TideGear/BoktaiSensor/README.md

I've done this all at my own expense.\
Please consider donating via...

 or 


https://ko-fi.com/TideGear

https://www.paypal.com/donate/?hosted_button_id=THMF458QTBCAL

----------------------------------------------------------------------

**Important!: This project is all very new, experimental, lightly-tested, and subject to change.\
I'm looking for serious contributors to...**

**1. Help tune the default device settings to *exactly* match how all three games handle a range of sunlight.** The defaults are roughly calibrated against real sunlight and a real Boktai 3 cartridge, but more testing across conditions and games is welcome. Where testing is ambiguous (e.g. flickering meter bar in the game), I tend to skew toward whatever is more "challenging" to achieve (seeking out more sunlight). The Ojo del Sol is meant to be the "no cheating" solution. However, keep in mind, I am talking about nit-picky, fractions of UVI.\
**2. Add support via Single Analog Control Mode to their emulators.**\
**3. Test and fix the code if needed.**\
**4. Create a cool 3D-printable case.**\
**5. You tell me!**

**...so please contact me if you are interested at TideGear @at@ gmail .dot. com !**

**Also contact me if you want to buy a pre-assembled device or kit!**

Photos of a build: https://photos.app.goo.gl/MvNCn2qLSqU6MgfA8 \
Made with this 1.7 x 1.7 x 0.79 inch case: https://a.co/d/01qMPdr9

----------------------------------------------------------------------

Ojo del Sol - ESP32-S3 UV Meter for Boktai Games
======================================================================

A substitute solar sensor for playing the Boktai series (Boktai 1, 2, 3)
on flash carts or emulators. Restores "Kojima's Intent" by using real
sunlight (UV) instead of artificial light hacks.

### Based on Prof9's Work

The GBA link cable ASM patches, IPS patches, and Ojo-del-Sol-side GBA link
protocol are based on [the gba-link-gpio branch of Prof9's Boktai Solar Sensor Patches](https://github.com/Prof9/Boktai-Solar-Sensor-Patches/tree/gba-link-gpio/Source).
Prof9's original code is released under the MIT License — see
[Prof9's license.txt](Prof9's%20license.txt) for details.

**Supported Games:**
- Boktai 1: The Sun Is in Your Hand (8-bar gauge)
- Boktai 2: Solar Boy Django (10-bar gauge)
- Boktai 3: Sabata's Counterattack (10-bar gauge)

----------------------------------------------------------------------

## Quick Start

**Recommended setup:** Incremental Mode (`HID_CONTROL_MODE = 0`) with mGBA libretro core (RetroArch), over either Bluetooth or USB XInput

1. Build the hardware (see [Hardware](#hardware) below)
2. Flash the firmware (see [Firmware Setup](#firmware-setup))
3. For mGBA libretro, set `HID_CONTROL_MODE = 0` in `config.h`
4. Pair the device as a Bluetooth controller in your OS
5. In mGBA (libretro), map **L3** to solar sensor decrease and **R3** to increase
6. Power on: hold button 2 seconds (T-QT Pro: the left button, next to USB; see [Button Controls](#button-controls))
7. Tap button to select game (BOKTAI 1, 2, or 3). (Optional) Tap to the **XInput** screen to view UV raw, UVI, compensated UVI, ADC avg, and battery voltage.
8. Point sensor toward the sky — the device syncs the in-game meter automatically
9. Hold button 2 seconds on a game screen to sleep. On the **XInput** screen, hold 2 seconds to enter CDC mode (USB serial / firmware upload).

**Important:** Only wake the device once you are in-game. The controller inputs it sends (button presses, stick deflections) may cause unwanted behavior in menus or other apps. When possible, put the device to sleep (hold 2s) when you are not actively playing a Boktai game.

**Important:** Placing the sensor behind standard glass or plastic blocks UV light. Use the `UV_ENCLOSURE_*` settings in `config.h` to compensate for your enclosure window. Strongly UV-blocking materials can still reduce usable range. The default transmittance (0.833) is currently a very quick and dirty calibration for these boxes: https://a.co/d/092sVvLT — adjust if you use a different enclosure.

----------------------------------------------------------------------

## Output Modes

The Ojo del Sol can output bar values in four ways. Choose based on your setup:

### 1. Bluetooth (Recommended for Emulators on PC or Mobile)
The device appears as an Xbox Series X controller ("Ojo del Sol Sensor") and sends button/stick inputs to control the emulator's solar sensor.

**Two HID control modes** (shared by Bluetooth and USB XInput; set via `HID_CONTROL_MODE` in config.h):

| Mode | How it works | Emulator support |
|---|---|---|
| **Incremental (default, mode 0)** | Sends L3/R3 button presses to step the meter up/down | **Works now** with mGBA libretro core |
| **Single Analog (mode 1)** | Better for Ojo del Sol! Maps bar count to proportional deflection on one analog axis | Requires emulator support |

**Current recommendation:** Use **Incremental Mode** with the **mGBA libretro core** in RetroArch until Single Analog Mode is supported by emulators (transport can be Bluetooth or USB XInput).

**Emulator developers:** See [For Emulator Devs.md](For%20Emulator%20Devs.md) for the Single Analog Mode specification, band mapping tables, and pseudocode.

### 2. USB XInput (Also Great for Emulators on PC or Mobile)
When `USB_HID_ENABLED = true`, normal boot enumerates as an Xbox 360-compatible USB XInput device (product string: `Ojo del Sol`) for emulator/game compatibility.
When `USB_HID_ENABLED = false`, the device automatically enters CDC mode on boot (one brief restart on first power-on or after a full power cycle; subsequent wakes return directly to CDC).
Both HID control modes are available over USB:
- **Incremental (`HID_CONTROL_MODE = 0`)**: sends `HID_BUTTON_DEC`/`HID_BUTTON_INC` step inputs and works independently of BLE state.
- **Single Analog (`HID_CONTROL_MODE = 1`)**: sends the configured axis plus optional unlock button (`HID_SINGLE_ANALOG_AXIS`, `HID_METER_UNLOCK_*`).

USB CDC serial is not active during normal XInput runtime. To enable USB serial (for `DEBUG_SERIAL` output or firmware upload):
1. Tap to the **XInput** screen (last screen in the cycle; this diagnostics screen is always present).
2. Hold the button for 2 seconds.
3. The device restarts into CDC mode and enumerates as `Ojo del Sol (CDC)`.

With `DEBUG_SERIAL = true`, CDC output includes startup diagnostics, device-button press events, and any enabled UV/battery debug streams.

In CDC mode the firmware runs fully (UV sensing, game display, screensaver, BLE, GBA link). The screen header shows **CDC** instead of **XInput**. Hold the button for 2 seconds from any screen to exit CDC mode and sleep; on next wake, the device boots back into XInput mode.

As an alternative, set `USB_HID_ENABLED = false` to have the firmware boot directly into CDC on wake.

### 3. GBA Link Cable (Best Option for Flash Carts)

This outputs a framed 3-wire value (SC + SD + SO) for use with a physical GBA via link cable. Supported on both boards (on the T-QT Pro it uses the board-edge solder pads IO16/IO17/IO18).

**Requirements:**
- Use the updated ROM hack IPS patches in this repo's `GBA Link Patches/` folder (`Source/` contains the ASM sources). Many thanks to Prof9 for the original proof-of-concept code!
- Recommended: install a real GBA link port on the Ojo del Sol and wire it as shown in [GBA Link Port Wiring.png](GBA%20Link%20Port%20Wiring.png). Link ports can be ordered here: https://a.co/d/00r3xzuj
- A breakout board also works, but the link cable can come loose easily if you move around much, so the real link port is the more robust option.
- Connect the Ojo del Sol to the **Player 1 (P1)** side of the cable and the GBA to the **Player 2 (P2)** side.

**Note:** The English translation of Boktai 3 should work with the patch, but this is currently untested.

**Limitation:** Boktai's normal link-cable modes (e.g., multiplayer) are **not compatible** with this and may never be. To use multiplayer alongside the Ojo del Sol, you'll need an emulator with link support (I've contacted Pizza Boy A Pro and Linkboy devs — TBD).

### 4. Display Only / Manual Entry (Not Recommended)
Read the bar count from the screen and enter it manually using Prof9's ROM hacks (https://github.com/Prof9/Boktai-Solar-Sensor-Patches). If you intend to use manual entry, **do not** use the ROM hacks in the GBA Link Patches directory. Those are for the GBA link cable method above.

**Note:** The screen is difficult to read in direct sunlight unless you shade it, so the display is really more for calibration and occasional reference.

----------------------------------------------------------------------

## Hardware

Two boards are supported. Select yours at the top of `config.h` (`BOARD_LILYGO_T_QT_PRO` is the default — see Option A below; uncomment `BOARD_SEEED_XIAO_ESP32S3` instead, and comment out the T-QT line, for the XIAO build in Option B).

### Option A: LilyGO T-QT Pro (minimal-wiring build, default)

The T-QT Pro build has been tested and works on real hardware. The GBA link solder pads are the least-exercised part, so please report any problems with them via a GitHub issue.

The [LilyGO T-QT Pro](https://github.com/Xinyuan-LilyGO/T-QT) has a built-in 0.85" 128x128 GC9107 color TFT, two buttons, battery charging, and battery voltage sensing — so the only wiring needed is the LTR390 and a battery.

**Components:**
- LilyGO T-QT Pro (ESP32-S3)
- Adafruit LTR390 UV Sensor (I2C) — connects to the T-QT's Qwiic connector; Adafruit's STEMMA QT version plugs straight in with a Qwiic/STEMMA QT cable, no soldering
- 3.7V LiPo battery (solder to the battery pads or use the connector, depending on your unit)

**T-QT Pro notes:**
- If you wire to the Qwiic connector manually instead of using a cable: SDA = GPIO43, SCL = GPIO44. (Beware: the pinout image and board silkscreen swap the Qwiic SDA/SCL labels; SDA = GPIO43, SCL = GPIO44 matches the schematic and actually works — [details](https://github.com/Xinyuan-LilyGO/T-QT/issues/17).)
- **Solder-pad sensor option:** set `I2C_SDA_PIN = 33` and `I2C_SCL_PIN = 34` in `config.h` to wire the sensor to the IO33/IO34 pads instead, freeing the Qwiic connector. I2C then needs pull-ups on SDA/SCL; the Adafruit LTR390 breakout includes 10K pull-ups on board, so no extra parts are needed with it.
- GBA link output is supported via the board-edge solder pads: IO16 (SC), IO17 (SD), IO18 (SO), plus the adjacent GND pad. See [GBA Link Cable Wiring](#gba-link-cable-wiring-optional).
- **Cartridge sensor option (untested):** a real Boktai cartridge can be wired up in place of the LTR390. See [Cartridge Sensor](#cartridge-sensor-t-qt-pro-optional--untested).
- Battery sensing is built in (2:1 divider on GPIO4) and enabled by default; no resistors needed.
- **Right button (GPIO47)** advances to the next screen (BOKTAI 1 → 2 → 3 → XInput). **Left button (GPIO0)** is the power button (hold 2s) — it is the only button that can wake the board from deep sleep — and a tap on it cycles screens backward.
- The UI renders as a 128x64 region centered on the square screen (top/bottom letterboxed). Set `TQT_DISPLAY_ROTATION` in `config.h` if your case orientation needs the screen flipped.

### Option B: Seeed XIAO ESP32S3 (original build)

**Components:**
- Seeed XIAO ESP32S3 (built-in LiPo charging)
- Adafruit LTR390 UV Sensor (I2C)
- SSD1306 128x64 OLED Display (I2C)
- Tactile push button (power/game select)
- 3.7V LiPo battery (300mAh works well; larger capacity is optional but be mindful of your case size)
- 2x 100K ohm resistors (for battery monitoring — optional but recommended)

### Wiring

*(XIAO ESP32S3 build only — the T-QT Pro just needs the LTR390 on the Qwiic connector (or the IO33/IO34 pads, see above) or a [cartridge](#cartridge-sensor-t-qt-pro-optional--untested), a battery, and the GBA link pads below if you use that output.)*

| Component | Pin | XIAO ESP32S3 | Notes |
|---|-----|---|---|
| OLED VIN | | 3V3 | 3.3V power |
| OLED GND | | GND | |
| LTR390 VIN | | 3V3 | 3.3V power |
| LTR390 GND | | GND | |
| OLED + LTR390 SDA | | D4 (GPIO5) | I2C data (configurable via `I2C_SDA_PIN`) |
| OLED + LTR390 SCL | | D5 (GPIO6) | I2C clock (configurable via `I2C_SCL_PIN`) |
| Button | Leg A | D0 (GPIO1) | Signal (internal pull-up) |
| Button | Leg B | GND | |
| Battery + | | BAT+ (back pad) | Farthest from USB-C |
| Battery - | | BAT- (back pad) | Closest to USB-C |

### Battery Monitoring (Optional)

The XIAO doesn't expose battery voltage directly. To enable battery percentage display, add a voltage divider:

```
BAT+ ----[100K]----+---- D1 (GPIO2)
                   |
                 [100K]
                   |
GND ---------------+
```

Battery sensing is disabled by default (`BATTERY_SENSE_ENABLED = false`). After wiring the divider, set `BATTERY_SENSE_ENABLED = true` in `config.h` to show battery data.

**Calibration:** If battery % is wrong at full charge, adjust `VOLT_DIVIDER_MULT` in config.h (increase if reading low, decrease if high).

### GBA Link Cable Wiring (Optional)

Only needed if using GBA Link output mode. Recommended: install a real GBA link port on the Ojo del Sol and wire it as shown in [GBA Link Port Wiring.png](GBA%20Link%20Port%20Wiring.png). Link ports can be ordered here: https://a.co/d/00r3xzuj

A breakout board such as the [Palmr breakout board](https://github.com/Palmr/gb-link-cable) still works, but the link cable can come loose easily if you intend to move around much. An actual link port is a much more robust solution.

**Recommended Ojo-side link port wiring (XIAO ESP32S3):**

| Ojo Connection | Ojo-side GBA Port Pin Type | Equivalent P1 Breakout Pad | Notes |
|---|---|---|---|
| D9 (GPIO8) | SI | SO | Payload bit 0 |
| GND | GND | SI | Shared ground |
| D8 (GPIO7) | SD | SD | Payload bit 1 |
| D7 (GPIO44) | SC | SC | Frame phase; toggles every `GBA_LINK_FRAME_TOGGLE_MS` |

**Recommended Ojo-side link port wiring (T-QT Pro):** same as above, using the board-edge solder pads next to the GND pad:

| Ojo Connection | Ojo-side GBA Port Pin Type | Equivalent P1 Breakout Pad | Notes |
|---|---|---|---|
| IO18 pad | SI | SO | Payload bit 0 |
| GND pad | GND | SI | Shared ground |
| IO17 pad | SD | SD | Payload bit 1 |
| IO16 pad | SC | SC | Frame phase; toggles every `GBA_LINK_FRAME_TOGGLE_MS` |

Leave the Ojo-side port `SO` and `VDD35` contacts unconnected. If you use a breakout board instead of a port, wire the equivalent P1 breakout pads listed above.

**Cheap cable continuity and cable orientation:**

Cheap GBA link cables have non-standard internal wiring (no mid-cable signal splitter), and the two ends are not equivalent. Plug the Ojo del Sol into the **Player 1 (P1)** side of the cable and the GBA into the **Player 2 (P2)** side.

Verify your specific cable's wiring with a multimeter continuity test. See [this sheet](https://docs.google.com/spreadsheets/d/19uAjLaDji9D3lIKIEdB9RHNQ_F-Fo1NnXY90uRH3dQA/edit?usp=sharing) for reference.

Expected continuity on this cheap-cable variant:
- P1 Pin 2 -> P2 Pin 3
- P1 Pin 3 -> P2 Pin 6
- P1 Pin 4 -> P2 Pin 4
- P1 Pin 5 -> P2 Pin 5

This wiring intentionally uses the conductor that routes P1 Pin 3 to P2 Pin 6 as the shared ground path between the Ojo and GBA.

**Important - shield and "GND" labels:**

- Shell/shield continuity is often missing on cheap cables, so do not assume shield gives ground reference.
- On this wiring method, shared ground comes from the P1 Pin 3 conductor routed to P2 Pin 6.

**`GBA_LINK_FRAME_TOGGLE_MS` explained:**

- This value is the hold time for one frame phase (`SC` low or high).
- One full 4-bit bar value needs two phases, so ideal full refresh time is roughly `2 * GBA_LINK_FRAME_TOGGLE_MS`.
- Firmware schedules phase timing with a microsecond clock, so `GBA_LINK_FRAME_TOGGLE_MS` is now honored much more closely than simple loop-delay timing.
- Example: `5ms` targets about `10ms` per full value (~100 full updates/sec), subject to normal loop jitter.
- Lower values respond faster but reduce electrical timing margin; higher values are slower but more tolerant.

**Notes:**
- Keep all signals at 3.3V logic (both supported boards are 3.3V native, so no level shifting is needed)
- The ESP32 writes data pins (SD, SO) before the phase pin (SC) so the GBA always samples stable data when it detects a phase edge. The GBA-side ASM patches include a consecutive-match check that discards any single-frame misread, adding one frame (~17ms) of latency on real bar changes but eliminating visible glitches.

### Cartridge Sensor (T-QT Pro, Optional) — UNTESTED

> **Status: untested.** This option compiles, but it has never been run with a cartridge attached. It uses the same reading method as the [Ojo del Sol Calibrator](OjoDelSolCalibrator/README.md), whose cartridge reading has not been run on hardware yet either. Expect to debug it, and please report results (working or not) via a GitHub issue.

Instead of the LTR390, the T-QT Pro build can read a **real Boktai cartridge's own solar sensor** over the GBA cartridge bus. It turns that reading into bars with the games' own level formula and bar tables. Two things keep it from being an exact copy of the game:
- **It needs a calibration number.** This is a dark baseline, `CART_CALIBRATION` (see below), and the default of 230 is a guess.
- **It reads every game with the Boktai 2/3 sequence.** Boktai 1's sequence differs slightly and may give a raw value one count higher. That should cancel out, because the calibration and the readings both come from the same sequence, but it is untested ([details](OjoDelSolCalibrator/README.md#not-verified-yet)).

It uses one sensor or the other, never both; to log a cartridge and an LTR390 side by side, use the calibrator.

To enable it, comment out `#define SENSOR_LTR390` and uncomment `#define SENSOR_GBA_CARTRIDGE` near the top of `config.h`. The XIAO build does not support it.

**Wiring (T-QT Pro):** the cartridge runs at 3.3 V, so no level shifting is needed. Cartridge pin numbers match [`References/gba_cartridge_pinout.svg`](References/gba_cartridge_pinout.svg).

"Cart VCC" below is the cartridge's switched supply from the power switch (next paragraph), or plain 3V3 if you leave the switch out.

| Cartridge pin(s) | Connect to |
|---|---|
| VCC (1) | Cart VCC |
| GND (32) | GND (the Qwiic connector's GND pin works) |
| /WR (3), /RD (4), /CS (5) | IO33, IO34, IO35 pads, each with a ~10 k pull-up to Cart VCC (recommended: the firmware floats these during deep sleep and boot, and the pull-ups keep the cartridge idle) |
| AD0–AD3 (6–9) | IO36, IO37, IO38, IO39 pads |
| AD5 (11), AD6 (12) | GPIO43, GPIO44 (the Qwiic connector's SDA and SCL; the LTR390 isn't used, so the connector is free) |
| AD4 (10) and AD7–AD15 (13–21) | each through ~10 k to GND |
| A16–A23 (22–29) | GND |
| /CS2 (30) | Cart VCC, wired directly |
| CLK (2), /IRQ (31) | leave unconnected |

**Cartridge power switch (recommended):** without it, the cartridge stays powered from 3V3 while the Ojo del Sol is asleep, and that sleep current is unmeasured. Use a logic-level P-channel MOSFET such as an AO3401A or Si2301. Connect its source to 3V3 and its drain to Cart VCC. Connect its gate to the IO48 pad, with a ~100 k resistor from the gate to 3V3. The firmware drives IO48 low to switch the cartridge on once the device has been powered on, and high again before sleeping or restarting. During deep sleep IO48 floats and the resistor keeps the switch off. Tie the pull-ups and /CS2 to Cart VCC, not 3V3, so they don't feed an unpowered cartridge. If you leave the switch out, wire Cart VCC straight to 3V3; the firmware's IO48 output then does nothing (or set `CART_POWER_PIN = -1`).

The tie-offs are the same as the calibrator's; its README explains [why each one is needed](OjoDelSolCalibrator/README.md#hardware). The pins can be changed in the `CARTRIDGE SENSOR` section of `config.h`. The GBA link pads (IO16–IO18) are still free, so the link output works alongside the cartridge; every other pad is in use. Power the board off before inserting or removing the cartridge.

**Setting it up:**
- **Calibration:** the game turns the cartridge's raw value into a 0–140 level with `level = calibration − raw`. It stores a reading taken during its sensor setup, minus 2, as its calibration; that part is confirmed from the ROM. It is not confirmed that the reading is meant to be taken in the dark, but that is the working assumption (the [calibrator README](OjoDelSolCalibrator/README.md#reading-the-data) makes the same one). So: cover the sensor, switch to the XInput/CDC screen, read **Raw**, and set `CART_CALIBRATION` to that value minus 2. The default of 230 is only a starting guess.
- **Boktai 1 (E):** set `CART_BOKTAI1_EUROPE_TABLE = true` so the BOKTAI 1 screen uses the European release's bar table (see [Automatic Mode](#automatic-mode-default)).
- The UV settings in [Calibration](#calibration) (`AUTO_UV_*`, enclosure compensation, smoothing, hysteresis) are not used.

**What changes:**
- The game screens show the cartridge's **Level** (0–140) instead of the UV index. They show **No cart** when the sensor never answered (no cartridge, or a wiring fault), and the meter then reads 0 bars.
- The XInput/CDC screen shows:
  - **Raw** and **Lvl:** the latest raw value and the level in use.
  - **Bus:** the read-back check (`ok` or `FAIL`, a rough wiring check) and how long the reading took.
  - **Late** and **Rej:** the latest reading's most delayed tick, and how many readings were discarded as late (see below).
- A reading starts every `CART_READ_INTERVAL_MS` (500 ms) and takes up to about 0.4 s, longest in the dark. Each sensor tick runs from a hardware timer interrupt, so the buttons, display and HID output keep running during a reading.
- **Protection against timing disturbance:** the timer interrupt runs on core 1, so the Bluetooth stack and controller (core 0) can't delay it. Flash writes, such as saving a Bluetooth pairing, still pause it briefly. Any reading with a tick more than `CART_TICK_MAX_LATE_US` (250 µs) late is discarded, and the previous level is kept. Set it to 0 to keep every reading.

**Not verified yet:**
- Everything on the calibrator's [not verified](OjoDelSolCalibrator/README.md#not-verified-yet) list about the bus timing, the tied-off lines and Boktai 1 cartridges.
- How sensitive the sensor is to tick timing at all, and so whether 250 µs is the right limit. Watch **Late** and **Rej** while Bluetooth is pairing and connected.
- The power switch: whether switching on the cartridge dips the 3V3 rail enough to reset the board, and the actual current draw, awake and asleep. GPIO43 is the boot ROM's serial output and sits high for a moment at power-up before the firmware floats it. While the cartridge is switched off, that can feed a little current into its AD5 pin.

----------------------------------------------------------------------

## Firmware Setup

### Libraries Required

**Install via Arduino Library Manager:**
- Adafruit LTR390 Library (not needed with the cartridge sensor)
- Adafruit SSD1306 (XIAO build only)
- Adafruit GFX Library
- Adafruit BusIO
- NimBLE-Arduino (by h2zero)
- Callback (by Tom Stewart)
- GFX Library for Arduino (by moononournation, a.k.a. Arduino_GFX) — **T-QT Pro build only**; no configuration needed, the display pins are fixed board wiring set in `TQTDisplay.h`

**Install manually (included in repo as ESP32-BLE-CompositeHID-master.zip, or download from GitHub):**
- ESP32-BLE-CompositeHID: https://github.com/Mystfit/ESP32-BLE-CompositeHID

**Why not TFT_eSPI (which LilyGO's own T-QT samples use)?** TFT_eSPI's last release (2.5.43) crashes in `tft.init()` on the ESP32-S3 under esp32 core 3.x (StoreProhibited panic → boot loop; [known issue](https://github.com/Bodmer/TFT_eSPI/issues/3329)). LilyGO's samples work because they bundle a modified TFT_eSPI and target the older 2.0.x core, but this project requires core 3.x. Arduino_GFX supports the GC9107 natively on current cores.

### Board Settings (Arduino IDE)

- **Boards Manager URL:** `https://raw.githubusercontent.com/espressif/arduino-esp32/gh-pages/package_esp32_index.json`
- **Board package:** esp32 by Espressif Systems, version 3.x
- **Board:**
  - XIAO build: **XIAO_ESP32S3**
  - T-QT Pro build: **ESP32S3 Dev Module** (no T-QT entry exists in the ESP32 core) with these settings — everything not listed stays at its default:
    - **Flash Size:** 4MB (32Mb) for the common N4R2 variant; 8MB (64Mb) for the N8 variant (chip marking `ESP32-S3FN4R2` = N4R2)
    - **PSRAM:** QSPI PSRAM (N4R2) or Disabled (N8)
    - **Partition Scheme:** Huge APP (3MB No OTA/1MB SPIFFS) — the sketch is too large for the default 1.2MB app partition
    - **Flash Mode:** QIO 80MHz, **CPU Frequency:** 240MHz, **Events/Arduino Run On:** Core 1 (the cartridge sensor's tick timer relies on this to stay off the Bluetooth core)
    - USB settings identical to the XIAO build (below)
- **USB Mode:** USB-OTG (TinyUSB)
- **USB CDC On Boot:** Enabled (required for CDC mode; normal runtime remains XInput unless you enter CDC mode from the XInput screen or set `USB_HID_ENABLED = false`)
- **Upload Mode:** USB-OTG CDC (TinyUSB) (required for CDC-mode uploads; UART0/Hardware CDC will fail to auto-connect in this setup)
- If CDC UI appears inconsistent/garbled after failed uploads, do one upload with **Erase All Flash Before Sketch Upload = Enabled**, then set it back to Disabled.
- Remember to select your board at the top of `config.h` as well (`BOARD_SEEED_XIAO_ESP32S3` or `BOARD_LILYGO_T_QT_PRO`), and the sensor just below it (`SENSOR_LTR390`, the default, or `SENSOR_GBA_CARTRIDGE`).

----------------------------------------------------------------------

## Usage

### Button Controls

**When device is ON:**
- **Tap:** Cycle screens (BOKTAI 1 → 2 → 3 → XInput → 1...). The XInput screen is always present and doubles as the diagnostics screen.
- **Hold 2s on a game screen:** Power OFF (deep sleep)
- **Hold 2s on the XInput screen:** Restart into CDC mode for USB serial output and firmware upload
- **Hold 2s while in CDC mode:** Exit CDC mode and sleep (next wake returns to XInput mode)
- If screensaver is active, first tap wakes the screen

**When waking from sleep:**
- **Hold 2s:** Power ON
- **Short press/tap:** Immediately shows "Hold 2s to power on"
- If there is no button activity for 10 seconds, it returns to sleep

**T-QT Pro:** The **right button** advances to the next screen when the device is on; it has no long-press action and cannot wake the device from sleep (hardware limitation — only GPIO0 is wake-capable). The **left button (GPIO0)** handles everything else described above (hold 2s for power/CDC), except its tap cycles screens *backward* instead of forward. Directions are configurable via `BUTTON_TAP_STEP`/`BUTTON2_TAP_STEP` in config.h.

### HID Control Mode Details (Bluetooth + USB)

**Incremental Mode specifics:**
- Works over both Bluetooth and USB XInput.
- The firmware tracks the in-game meter state and sends L3/R3 presses to sync it
- On BLE connections, performs a clamp+refill resync every `BLE_RESYNC_INTERVAL_MS` (default 60s)
- Press rate controlled by `HID_BUTTONS_PER_SECOND` (default 20)
- For Boktai 1, mGBA uses 10 internal steps despite 8 visible bars — the firmware compensates (disable via `HID_BOKTAI1_MGBA_10_STEP_WORKAROUND = false` if fixed)
- **Button remapping:** Change `HID_BUTTON_DEC` and `HID_BUTTON_INC` in config.h to use different buttons (see `XboxGamepadDevice.h` for available constants)

**Single Analog Mode specifics:**
- Works over both Bluetooth and USB XInput.
- Updates immediately on bar change (no rate throttling)
- Maps bar count to a proportional deflection on a configurable analog axis (default: Right X+)
- Optionally holds a configurable "meter unlock" button (default: R3) while the axis is active (`HID_METER_UNLOCK_BUTTON_ENABLED`). Single Analog mode uses midpoint band mapping, so even 0 bars sends a small deflection (not exact center).
- Bluetooth path: the unlock button is released/re-pressed on each deflection change and periodically (`HID_METER_UNLOCK_REFRESH_MS`, default 1000ms) so apps/emulators that start listening late can still register it as held.
- USB path: the unlock button is held while active and updated with normal USB reports (no periodic release/re-press refresh cycle).
- Axis and unlock button are configurable in config.h (`HID_SINGLE_ANALOG_AXIS`, `HID_METER_UNLOCK_BUTTON`)

### Bluetooth-Specific Details

The device advertises as "Ojo del Sol Sensor" (configurable via `BLE_DEVICE_NAME`).

**Pairing/connection behavior:**
- Times out after `BLE_PAIRING_TIMEOUT_MS` (default 60s)
- Re-enters pairing if connection drops
- **Pairing restarts on wake** — after waking from sleep, the device re-advertises for pairing
- Bluetooth icon flashes while pairing, solid when connected

### Screensaver

After `SCREENSAVER_TIME` minutes (default 3) of no button activity, the display shows a bouncing "Ojo del Sol" logo. Press any button to wake. Set `SCREENSAVER_TIME = 0` to disable (but this affects OLED lifespan). Alternatively, set `SCREENSAVER_ACTIVE = false` to disable it without changing the time value. The status row appears only when battery data is available and/or BLE is actively connected or pairing.

On the T-QT Pro the screensaver is disabled by default (`SCREENSAVER_ACTIVE = false` in its branch of `config.h`): its LCD isn't prone to OLED-style burn-in, and the screensaver leaves the backlight on, so it would save no power. Set it to `true` if you want it anyway.

----------------------------------------------------------------------

## Calibration

*(LTR390 builds. With the [cartridge sensor](#cartridge-sensor-t-qt-pro-optional--untested), only `CART_CALIBRATION` applies.)*

### Automatic Mode (Default)

Bar thresholds are calculated from two values in config.h:

```c
const bool AUTO_MODE = true;
const float AUTO_UV_MIN = 1.000;   // UV Index for 1 bar
const float AUTO_UV_SATURATION = 13.100;   // UV Index ceiling (output clamp)
```

Bars are distributed non-linearly following the original Boktai cartridge's thresholds (per [Raphi's sensor graph](https://raphi.xyz/~raphi/boktai/sensor_graph/)), scaled across the configured UV range. `AUTO_UV_MIN` is where bar 1 starts; `AUTO_UV_SATURATION` is where the highest bar starts (and all values above are clamped to max).

**Original cartridge bar thresholds** (0–140 scale; source: [raphi.xyz/~raphi/boktai/sensor_graph/](https://raphi.xyz/~raphi/boktai/sensor_graph/)):

```
Exclusive upper bound
Bars    Boktai 1    Boktai 2 & 3
0       1           1
1       7           6
2       16          13
3       28          23
4       44          35
5       67          50
6       98          67
7       140         87
8       (max)       110
9       —           140
10      —           (max)
```

The Boktai 1 column above matches the Japanese and US releases. **Boktai 1 (E)** (Europe) uses different thresholds, found by disassembling the ROM's bar-ladder routine (the first value at which each bar starts, in the same 0–140 scale):

```
Bars    Boktai 1 (E)
1       1
2       7
3       15
4       25
5       38
6       56
7       98
8       140
```

This differs from Raphi's Boktai 1 table (bars 3–6 start at 16, 28, 44 and 67 there). The config.h thresholds follow Raphi's table, so they do not reproduce the European release's gauge exactly.

`AUTO_UV_MIN` maps to scaled value 1 and `AUTO_UV_SATURATION` maps to 140.

### Manual Mode

Set `AUTO_MODE = false` to use per-game `BOKTAI_1/2/3_UV_MIN` and `BOKTAI_1/2/3_UV_SATURATION` values (`BOKTAI_1_UV_MIN`, `BOKTAI_1_UV_SATURATION`, etc.). Bar thresholds follow the same non-linear cartridge curve as AUTO mode, but each game can use a different UV range.

### Transparent Enclosure Compensation

If the sensor is behind a transparent window, model that window as transmission loss:

```c
const bool UV_ENCLOSURE_COMP_ENABLED = true;
const float UV_ENCLOSURE_TRANSMITTANCE = 0.42; // 42% UV passes through the window
const float UV_ENCLOSURE_UVI_OFFSET = 0.000;     // Optional bias correction
```

The current repo default in `config.h` is `0.833`, based on the enclosure linked above; expect to recalibrate this value for your own case/window material.

Firmware applies compensation once after raw-to-UVI conversion:

`corrected_uvi = max(0, (measured_uvi - offset) / transmittance)`

Quick calibration:
1. Temporarily set `UV_ENCLOSURE_COMP_ENABLED = false` while collecting calibration readings.
2. Take side-by-side readings at the same time/angle: one sensor open-air, one in-box.
3. Compute `in_box_uvi / open_air_uvi` across several samples.
4. Use the median ratio as `UV_ENCLOSURE_TRANSMITTANCE`.
5. Re-enable compensation (`UV_ENCLOSURE_COMP_ENABLED = true`).

**Threshold calibration mode:** By default (`UV_THRESHOLDS_CALIBRATED_OPEN_AIR = true`), all threshold values in config.h (`AUTO_UV_MIN`, `AUTO_UV_SATURATION`, and the per-game `BOKTAI_*_UV_MIN`/`BOKTAI_*_UV_SATURATION` values) are assumed to be open-air UVI values — set while the case is open or without an enclosure. The firmware compensates sensor readings to open-air equivalent before comparing against them. Set `UV_THRESHOLDS_CALIBRATED_OPEN_AIR = false` if you instead calibrated thresholds with the sensor inside the closed enclosure; bar comparison will then use the raw (uncompensated) reading directly.

For open-air builds (sensor always exposed when device is in use): set `UV_ENCLOSURE_COMP_ENABLED = false` and leave `UV_THRESHOLDS_CALIBRATED_OPEN_AIR = true`. Compensation is a no-op so raw equals compensated.

Note: On the XInput screen, `UVI` is the measured (pre-compensation) value and `UVI comp'ed` is the value used for bar calculation (post-compensation; post-smoothing if `UVI_SMOOTHING_ENABLED = true`).

### Stability Tuning

If the bar display feels jumpy:
- `UVI_SMOOTHING_ENABLED`: Applies exponential smoothing (default: `false`; set `true` to smooth)
- `UVI_SMOOTHING_ALPHA`: Controls how much weight new readings get vs. the running average (default: `0.5`; higher = faster response, lower = smoother). Setting `UVI_SMOOTHING_ALPHA = 1.0` is the same as `UVI_SMOOTHING_ENABLED = false`.
- `BAR_HYSTERESIS_ENABLED`: Enables bar hysteresis (default: `false`). Setting `BAR_HYSTERESIS_ENABLED = false` is the same as `BAR_HYSTERESIS = 0.0`.
- `BAR_HYSTERESIS`: Requires UV margin before changing bars (default: `0.200`; only used when `BAR_HYSTERESIS_ENABLED = true`)

----------------------------------------------------------------------

## Ojo del Sol Calibrator — PARTLY TESTED

A separate device (partly tested: the Wi-Fi, web app, logging and LTR390 work on the board; the cartridge side has not been tried yet) in [`OjoDelSolCalibrator/`](OjoDelSolCalibrator/) that reads a real Boktai cartridge's solar sensor and an LTR390 at the same moment and logs both, to tune `AUTO_UV_MIN`, `AUTO_UV_SATURATION` and the bar thresholds against the real hardware. See the [calibrator README](OjoDelSolCalibrator/README.md) for its hardware, wiring, firmware setup and Wi-Fi web app.

----------------------------------------------------------------------

## Technical Notes

### Original Boktai Cartridge Sensor (from GBATEK and Drakodan)
- **Chip**: Hamamatsu Photonics G5842 (UV photodiode with 8-bit ADC)
- **Spectral range**: 260–400nm, centered at ~370nm (UV-A dominant)
- Values **inverted**: 0xE8 = darkness, 0x50 = max gauge, 0x00 = extreme
- Accessed via GPIO at 0x80000C4-0x80000C8

### LTR390 UV Sensor
- Reference sensitivity: 2300 counts/UVI at 18x gain, 400ms integration
- Formula (measured): `UVI = raw / 2300` (at our settings: gain 18x, 20-bit/400ms, 500ms rate)
- Formula (corrected, optional enclosure compensation): `UVI = max(0, (measured_uvi - offset) / transmittance)`
- Peak response: 300-350nm (UV-A/UV-B)
- **Not inverted**: higher values = more UV

### Power Management
- Wire the LTR390 directly to `3V3`, same as the OLED
- Cutting the LTR390 breakout LED trace is recommended because the LED is hardwired to VIN
- Battery sensing is enabled by default on the T-QT Pro (built-in divider) and disabled by default on the XIAO build; low-voltage cutoff is disabled by default on both. Enable them after wiring (XIAO) and validating the battery divider (`BATTERY_SENSE_ENABLED`, `BATTERY_CUTOFF_ENABLED`)
- Battery sampling/cutoff checks run on a timed loop and are not dependent on UV "new data" events
- XIAO build: the OLED uses Display OFF + Charge Pump OFF commands, and on wake the firmware explicitly re-enables the charge pump/display before drawing
- T-QT Pro: the panel is put to sleep and the backlight cut; the backlight pin is held off through deep sleep
- Deep sleep current: not measured on either board

### UV Blocking Warning
Most glass and many plastics block UV strongly (often 90%+). Compensation can correct scale loss, but it cannot recover signal if too little UV reaches the sensor. Prefer an open aperture, quartz glass, or UV-transparent acrylic.

----------------------------------------------------------------------

## Troubleshooting

### UV sensor reads 0 or very low
If button presses are being seen, Serial should print `Device button pressed` whenever the device button is pressed.
1. Set `DEBUG_SERIAL = true` and check Serial Monitor (115200 baud). Serial output is only active in CDC mode — enter CDC mode from the XInput screen (hold 2s), or set `USB_HID_ENABLED = false` to always use CDC.
   - At UVI 6, expect ~13800 raw counts (6 × 2300)
   - If raw = 0, sensor may not be in UV mode
2. Ensure sensor faces the sky (not blocked by hand/case)
3. If using an enclosure window, verify `UV_ENCLOSURE_TRANSMITTANCE` and use UV-transparent material
4. Indoor UV is near zero — test outside

### Battery shows 0%
XIAO build: you need the voltage divider circuit and `BATTERY_SENSE_ENABLED = true`. Keep battery sensing disabled until the divider is wired. (The T-QT Pro's divider is built in, so this doesn't apply there.)

### Battery % is wrong
Adjust `VOLT_DIVIDER_MULT` in config.h (increase if reading low, decrease if high).

### Device powers off quickly
Check `BATTERY_CUTOFF_ENABLED` and `VOLT_CUTOFF`. Cutoff is disabled by default; only enable it after battery sensing is wired and validated.

### Device won't wake
1. Hold button for full 2 seconds
2. A short press should immediately show the "Hold 2s to power on" prompt
3. After 10s of no activity, it returns to sleep
4. If the display fails to initialize, the device enters deep sleep after about 2 seconds using the normal sleep path (same cleanup and button-release debounce as manual sleep). On the XIAO build, check I2C wiring and `DISPLAY_I2C_ADDR` in config.h (some modules use `0x3D` instead of `0x3C`)
5. T-QT Pro: only the **left button (GPIO0, next to USB)** can wake the device — the right button does nothing while asleep

### Display is blank, mirrored, or inverted after entering CDC mode
1. Update to the latest firmware (the boot sequence now re-asserts OLED power and canonical panel state after the software restart)
2. Confirm `Tools > Upload Mode` is set to `USB-OTG CDC (TinyUSB)`
3. If needed, re-enter CDC mode once (hold 2s on the XInput screen), then upload again

### BLE crashes at startup (`block_locate_free` TLSF assert)
This was a known compatibility issue between esp32 core `3.3.7` and older versions of NimBLE-Arduino. It is resolved as of NimBLE-Arduino v2.3.9 — update the library via Arduino Library Manager and rebuild.

### T-QT Pro: build fails with `Arduino_GFX_Library.h: No such file or directory`
Install "GFX Library for Arduino" (by moononournation) via the Library Manager.

### T-QT Pro: boot loop / COM port keeps disconnecting and reconnecting
If you modified the code to use TFT_eSPI: its last release (2.5.43) crashes at `tft.init()` on ESP32-S3 with esp32 core 3.x — this firmware uses Arduino_GFX instead for exactly that reason. Otherwise, set `USB_HID_ENABLED = false` temporarily and watch the serial monitor: the firmware prints a boot banner and a marker after each init stage, so the last line tells you which step crashes.

### T-QT Pro: screen shows garbage, wrong colors, or an offset image
T-QT units exist with two panel revisions (LilyGO ships separate factory firmware for the newer panel). Arduino_GFX's GC9107 driver works on the unit this project was tested with, but only one revision has been tried; if your unit misbehaves, try `TQT_DISPLAY_ROTATION` values 0-3 in config.h first, then report it via a GitHub issue — the panel-specific init from LilyGO's [`extras` folder](https://github.com/Xinyuan-LilyGO/T-QT/tree/main/extras) may need porting.

----------------------------------------------------------------------

## Future Plans

- [ ] Lunar Knights support?

----------------------------------------------------------------------

## Credits & Links

- **[Prof9](https://github.com/Prof9/Boktai-Solar-Sensor-Patches)** — GBA link patches, IPS patches, and link protocol are based on Prof9's work (MIT License — see [Prof9's license.txt](Prof9's%20license.txt)) Prof9 also provided a ridiculous amount of help, patience, and kindness. Many thanks!
- **[Raphi](https://raphi.xyz/~raphi/boktai/sensor_graph/)** — Original Boktai cartridge bar threshold tables, reverse-engineered from the original hardware. This saved me a lot of work!
- **[Mystfit](https://github.com/Mystfit/ESP32-BLE-CompositeHID)** — ESP32-BLE-CompositeHID library (included as `ESP32-BLE-CompositeHID-master.zip`)
- **[Kalasoiro](https://github.com/Kalasoiro/esp32s3-tinyusb-xinput)** - XInput TinyUSB reference implementation (included as `esp32s3-tinyusb-xinput-main.zip`)
- **LanHikariDS** — Additional support via Discord
- **[Drakodan](https://tasvideos.org/9369S)** — Original cartridge sensor chip identification (Hamamatsu Photonics G5842) and spectral range documentation
- [GBATEK Solar Sensor Documentation](https://problemkaputt.de/gbatek.htm)
- [Seeed XIAO ESP32S3 Wiki](https://wiki.seeedstudio.com/xiao_esp32s3_getting_started/)
- [Adafruit LTR390](https://www.adafruit.com/product/4831)

----------------------------------------------------------------------

## Legal Disclaimer

This project is for hobbyist and entertainment use only and does not provide medical advice. Consult a physician or other qualified healthcare professional for guidance on safe and appropriate sunlight exposure for your situation.

Do not rely on video games or the Ojo del Sol as an indicator of how much sunlight or UV exposure you should get. They are gameplay devices, not health or safety instruments.

This project is an independent fan-made hardware/firmware project and is not affiliated with, endorsed by, or sponsored by Konami or Hideo Kojima.
