TideGear/BoktaiSensor/References/UV Sensor.jpg

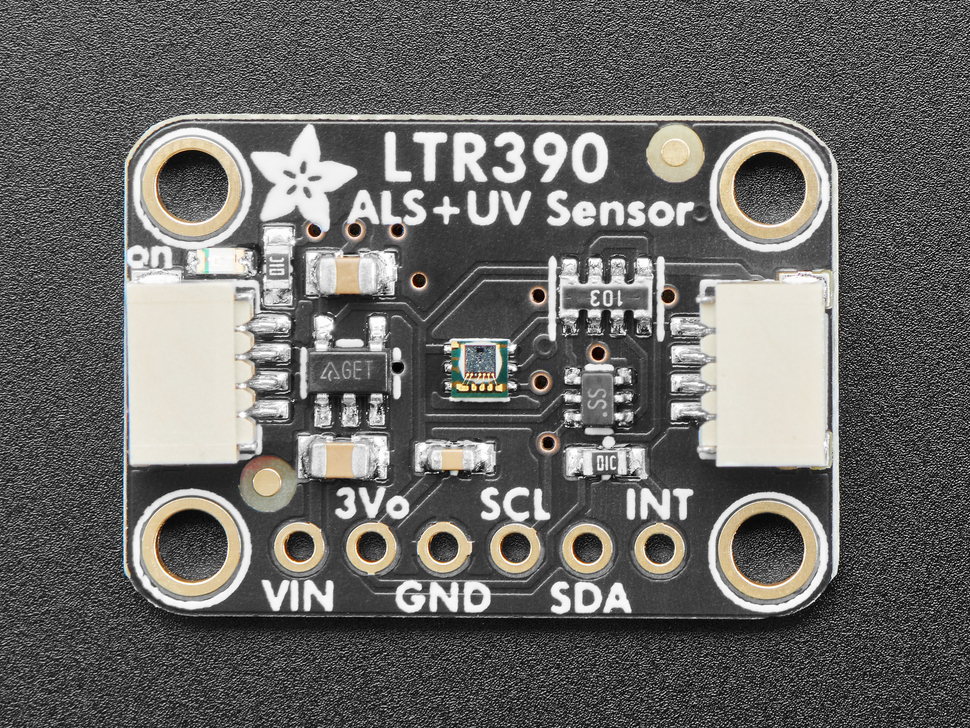
References/UV Sensor.jpg
