TideGear/BoktaiSensor/References/XIAO ESP32S3 front.png

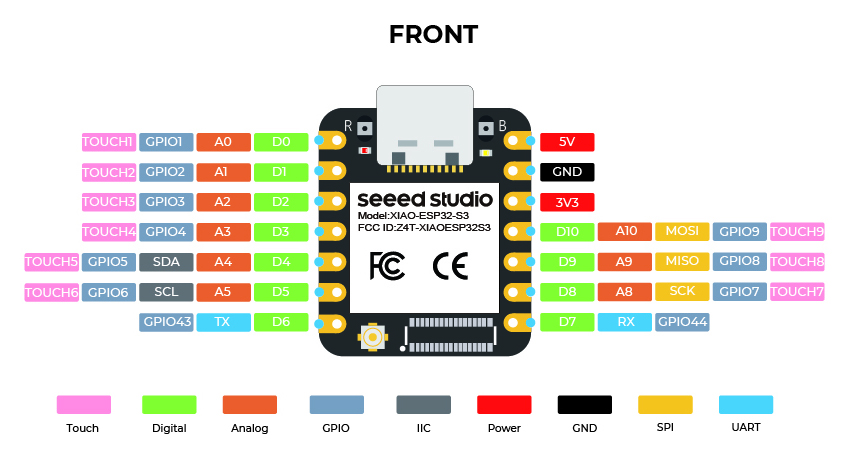
References/XIAO ESP32S3 front.png
