TideGear/BoktaiSensor/GBA Link Port Wiring.png

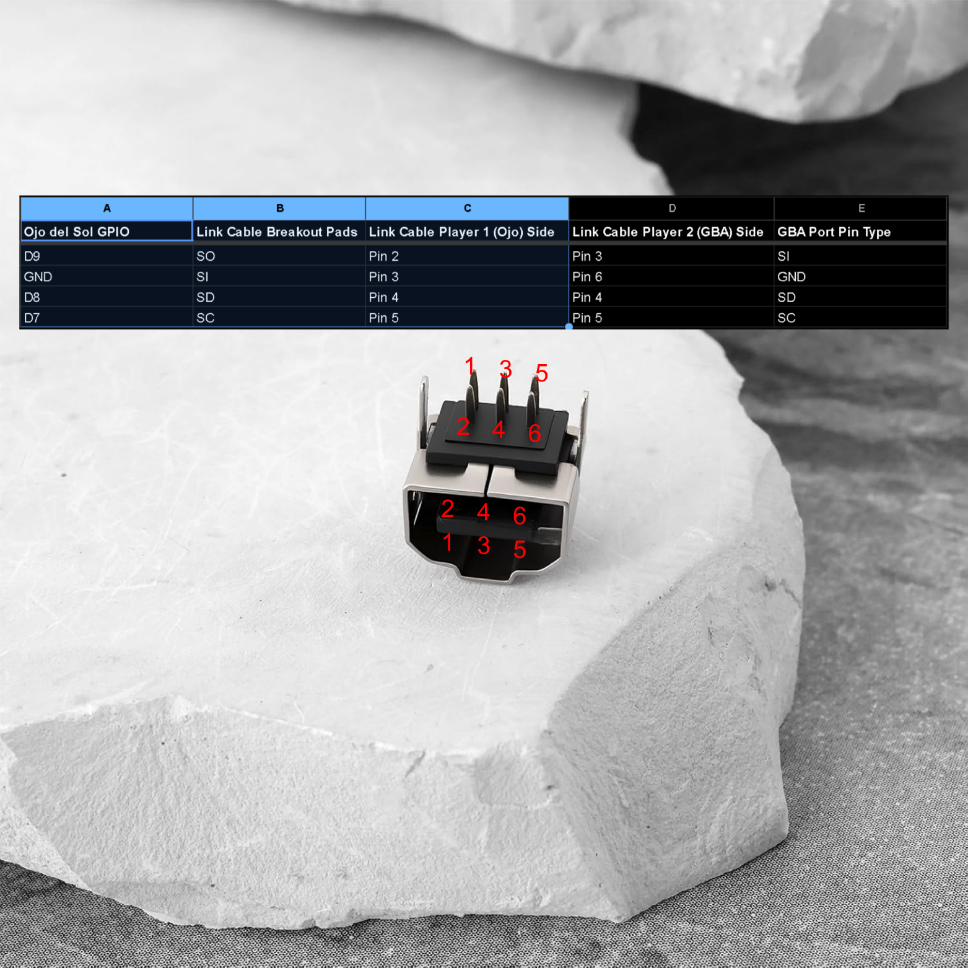
GBA Link Port Wiring.png
