TideGear/BoktaiSensor/OjoDelSolCalibrator/screenshots/web-live-desktop.png

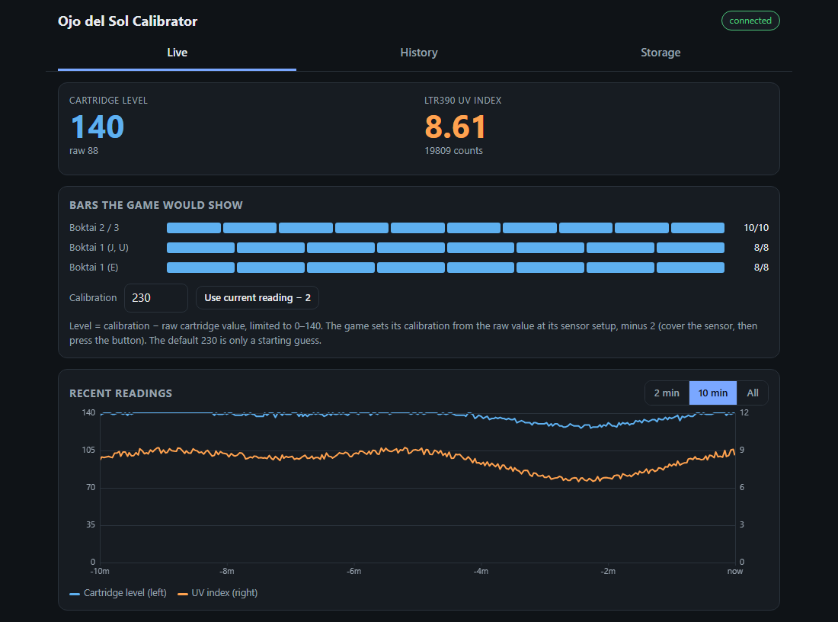
OjoDelSolCalibrator/screenshots/web-live-desktop.png
