TideGear/BoktaiSensor/OjoDelSolCalibrator/screenshots/web-history-desktop.png

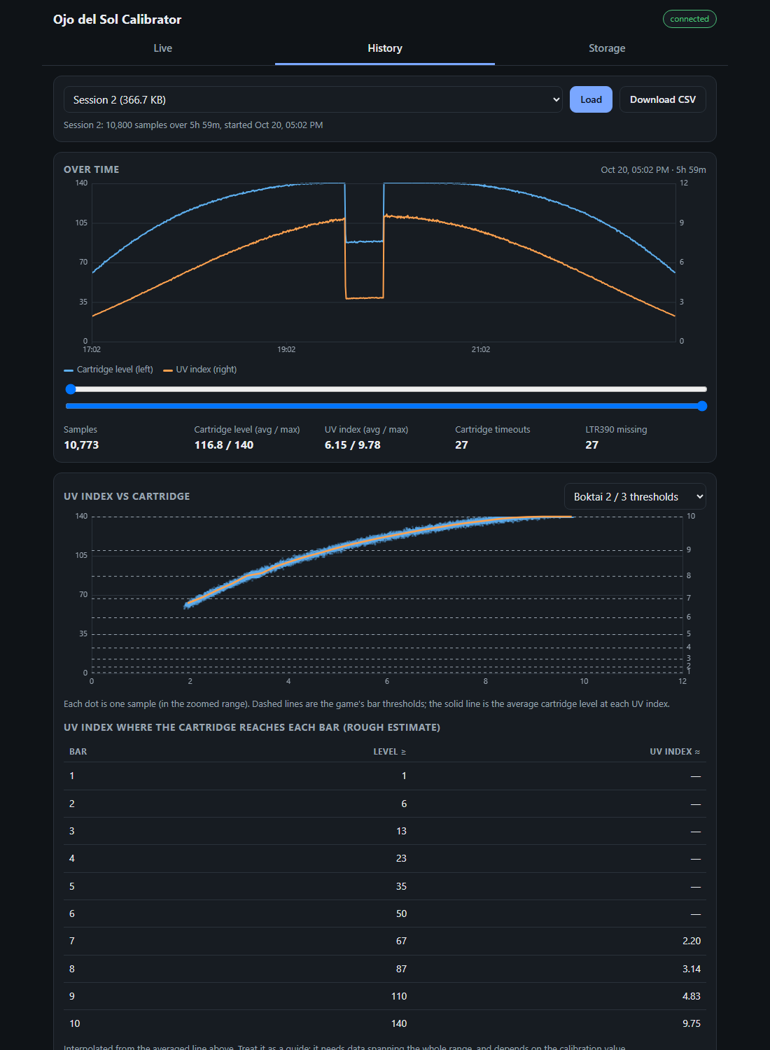
OjoDelSolCalibrator/screenshots/web-history-desktop.png
