TideGear/BoktaiSensor/BoktaiSensor.ino

#include <Wire.h>
#include <Adafruit_GFX.h>
#include "config.h"
#if defined(BOARD_LILYGO_T_QT_PRO)
#include "TQTDisplay.h"
#include "driver/gpio.h"
#else
#include <Adafruit_SSD1306.h>
#endif
#if defined(SENSOR_LTR390)
#include "Adafruit_LTR390.h"
#else
#include "GbaCartSensor.h"
#endif
#include "esp_sleep.h"
#include "esp_attr.h"       // RTC_DATA_ATTR
#include "driver/rtc_io.h"  // rtc_gpio_pullup_en for the deep-sleep wake pin
#include <BleCompositeHID.h>
#include <XboxGamepadDevice.h>
#include <XboxGamepadConfiguration.h>
#include <NimBLEDevice.h>
#include <NimBLEServer.h>

// USB XInput gamepad (requires USB Mode: USB-OTG/TinyUSB in board settings)
#if defined(ARDUINO_USB_MODE) && !ARDUINO_USB_MODE
#include "USB.h"
#include "XboxHIDGamepad.h"
#define HAS_USB_HID 1
#else
#define HAS_USB_HID 0
#endif

// Display settings
// The UI is authored at 128x64. On the XIAO build that is the physical
// SSD1306 OLED; on the T-QT Pro it is a canvas pushed centered onto the
// 128x128 TFT.
#define SCREEN_WIDTH 128
#define SCREEN_HEIGHT 64
#if defined(BOARD_LILYGO_T_QT_PRO)
TQTDisplay display(SCREEN_WIDTH, SCREEN_HEIGHT);
#define DISPLAY_WHITE 1
#else
Adafruit_SSD1306 display(SCREEN_WIDTH, SCREEN_HEIGHT, &Wire, -1);
#define DISPLAY_WHITE SSD1306_WHITE
#endif
bool displayInitialized = false;
// Icon dimensions (shared by status bar and screensaver)
const int16_t STATUS_BATT_ICON_W = 20;
const int16_t STATUS_BATT_ICON_H = 9;
const int16_t STATUS_BT_ICON_W = 8;
const int16_t STATUS_BT_ICON_H = 10;
const int16_t STATUS_BT_GAP = 2;
const int16_t STATUS_TEXT_GAP = 2;
const int16_t STATUS_RIGHT_MARGIN = 3;
#if !defined(BOARD_LILYGO_T_QT_PRO)
const uint8_t SSD1306_CHARGEPUMP_DISABLE = 0x10;
const uint8_t SSD1306_CHARGEPUMP_ENABLE = 0x14;
const uint8_t SSD1306_DEACTIVATE_SCROLL_CMD = 0x2E;
const uint8_t SSD1306_DISPLAYALLON_RESUME_CMD = 0xA4;
const uint8_t SSD1306_NORMALDISPLAY_CMD = 0xA6;
const uint8_t SSD1306_SEGREMAP_DEFAULT = 0xA1;
const uint8_t SSD1306_COMSCANDEC_CMD = 0xC8;
const uint8_t SSD1306_SETDISPLAYOFFSET_CMD = 0xD3;
const uint8_t SSD1306_SETSTARTLINE0_CMD = 0x40;
#endif

// Sensor settings
#if defined(SENSOR_LTR390)
Adafruit_LTR390 ltr = Adafruit_LTR390();
#else
// Latest cartridge reading (shown on the debug screen), the 0-140 level from
// the latest reading that was kept, and how many were discarded as late
CartReading lastCartReading = { false, 0, false, 0, 0 };
bool hasCartReading = false;
int cachedCartLevel = 0;
uint32_t cartLateReadings = 0;
#endif

// UV Index calculation per LTR-390UV datasheet (DS86-2015-0004)
// Reference: 2300 counts/UVI at 18x gain, 400ms (20-bit) integration
// Formula: UVI = raw * (18/gain) * (400/int_time) / 2300
//
// For 18x gain, 20-bit (400ms):
//   UVI = raw / 2300
const float UV_SENSITIVITY_COUNTS_PER_UVI = 2300.0f;
const float UV_REFERENCE_GAIN = 18.0f;
const float UV_REFERENCE_INT_MS = 400.0f;
float uvDivisor = UV_SENSITIVITY_COUNTS_PER_UVI;
const uint8_t MEAS_RATE_500MS = 0x04;

// Power button state tracking
unsigned long buttonPressStart = 0;
bool buttonWasPressed = false;

// Secondary button state (unused when BUTTON2_ENABLED is false)
unsigned long button2PressStart = 0;
bool button2WasPressed = false;
bool button2SuppressShortPress = false;

// Game selection (0 = Boktai 1, 1 = Boktai 2, 2 = Boktai 3)
int currentGame = 0;
const int DEBUG_SCREEN_INDEX = NUM_GAMES;
const int NUM_UI_SCREENS = NUM_GAMES + 1;

// UI screen selection:
// 0..NUM_GAMES-1 = game screens, DEBUG_SCREEN_INDEX = XInput/CDC debug screen
//
// Held in RTC memory so the selected screen survives the reset that deep-sleep
// wake performs. Statically initialized to 0, which applies on a cold power-on
// (RTC memory is only reloaded from flash then, not on a wake). Validated in
// restoreUiScreenAfterReset() before use.
RTC_DATA_ATTR int currentScreen = 0;
bool uiScreenChanged = false;

// Battery state
unsigned long lastBatterySampleTime = 0;
const int BATTERY_PCT_UNKNOWN = -1;
int cachedBatteryPct = BATTERY_PCT_UNKNOWN;
float cachedBatteryVoltage = -1.0f;
float cachedBatteryAdcAvg = -1.0f;
bool hasBatteryReading = false;
unsigned long lowBatteryStart = 0;

// Screensaver state
const char SCREENSAVER_TEXT[] = "Ojo del Sol";
const bool SCREENSAVER_ENABLED = SCREENSAVER_ACTIVE && (SCREENSAVER_TIME > 0);
const unsigned long SCREENSAVER_TIMEOUT_MS = SCREENSAVER_TIME * 60UL * 1000UL;
const unsigned long SCREENSAVER_MOVE_MS = 60;
const int16_t SCREENSAVER_IMAGE_W = 24;
const int16_t SCREENSAVER_IMAGE_H = 24;
const int16_t SCREENSAVER_IMAGE_TEXT_GAP = 8;
const int16_t SCREENSAVER_TEXT_BATT_GAP = 8;
const int16_t SCREENSAVER_BATT_GAP = 2;

const uint8_t OJO_DEL_SOL_BITMAP[] PROGMEM = {
  0x00, 0x00, 0x00, 0x00, 0x02, 0x00, 0x08, 0x0C, 0x00, 0x08, 0x18, 0x00,
  0x0C, 0x18, 0x3C, 0x0E, 0x00, 0x70, 0x04, 0x00, 0x20, 0x00, 0x3C, 0x00,
  0x00, 0xDB, 0x00, 0x81, 0x42, 0x80, 0x42, 0x00, 0x40, 0x71, 0x85, 0x8C,
  0x33, 0x81, 0xCE, 0x03, 0x81, 0xC2, 0x01, 0xC3, 0x81, 0x00, 0xFF, 0x00,
  0x00, 0x7E, 0x00, 0x04, 0x00, 0x20, 0x0E, 0x00, 0x70, 0x3C, 0x18, 0x30,
  0x00, 0x18, 0x10, 0x00, 0x30, 0x10, 0x00, 0x40, 0x00, 0x00, 0x00, 0x00
};
unsigned long lastScreenActivityMs = 0;
unsigned long lastScreensaverMoveMs = 0;
bool screensaverActive = false;
bool screensaverJustExited = false;
bool suppressShortPress = false;
int16_t screensaverX = 0;
int16_t screensaverY = 0;
int8_t screensaverDx = 1;
int8_t screensaverDy = 1;
int16_t screensaverTextW = 0;
int16_t screensaverTextH = 0;
int16_t screensaverTextX1 = 0;
int16_t screensaverTextY1 = 0;

// Cached display values
uint32_t cachedRawUVS = 0;
float cachedUviRaw = 0.0f;
float cachedUvi = 0.0f;
int cachedFilledBars = 0;
int cachedNumBars = 0;
float smoothedUvi = 0.0f;
bool hasSmoothedUvi = false;
bool gameChanged = false;
bool hidGameChanged = false;
bool gbaFramePhaseHigh = false;
unsigned long gbaFrameLastToggleUs = 0;

// BLE state
XboxGamepadDevice* xboxGamepad = nullptr;
XboxSeriesXControllerDeviceConfiguration* xboxConfig = nullptr;
BleCompositeHID compositeHID(BLE_DEVICE_NAME, BLE_MANUFACTURER, 100);  // Initial battery level; updated once battery is read
unsigned long blePressIntervalMs = 0;  // Set by initHidPressTiming()
unsigned long blePressHoldMs = 0;      // Set by initHidPressTiming()
bool bleConnected = false;
bool blePairingActive = false;
unsigned long blePairingStartMs = 0;
bool bleIconFlashOn = true;
unsigned long bleIconLastToggleMs = 0;
bool bleSyncPending = false;
unsigned long bleLastResyncMs = 0;
int bleDeviceBars = 0;
int bleDeviceNumBars = 0;
bool bleEstimateValid = false;
int bleEstimatedSteps = 0;
bool blePressHolding = false;
unsigned long blePressStartMs = 0;
unsigned long bleLastPressMs = 0;
int blePressDirection = 0;
uint16_t bleActiveButton = 0;
int bleSyncTargetSteps = 0;
int bleSyncStepsMax = 0;
int bleSyncRemaining = 0;
int bleSyncDirection = 0;
int bleRefillRemaining = 0;
int bleRefillDirection = 0;
const unsigned long BLE_ICON_FLASH_MS = 500;
const int BLE_DIR_DEC = -1;
const int BLE_DIR_INC = 1;
const int BOKTAI1_STEP_COUNT = 10;
const int BOKTAI1_STEP_TO_BAR[BOKTAI1_STEP_COUNT + 1] = { 0, 1, 2, 3, 3, 4, 5, 6, 7, 7, 8 };
const int BOKTAI1_BAR_TO_STEP_FROM_EMPTY[9] = { 0, 1, 2, 3, 5, 6, 7, 8, 10 };
const int BOKTAI1_BAR_TO_STEP_FROM_FULL[9] = { 0, 1, 2, 4, 5, 6, 7, 9, 10 };
enum BleSyncPhase {
  BLE_SYNC_NONE = 0,
  BLE_SYNC_CLAMP,
  BLE_SYNC_REFILL
};
BleSyncPhase bleSyncPhase = BLE_SYNC_NONE;
// Single Analog mode state
int bleSingleAnalogBars = -1;
int16_t bleSingleAnalogValue = 0;
bool bleSingleAnalogActive = false;
bool bleSingleAnalogButtonHeld = false;
unsigned long bleSingleAnalogLastRefreshMs = 0;

// USB XInput state
#if HAS_USB_HID
XboxHIDGamepad usbGamepad;
bool cdcRequireButtonRelease = false;
#endif
bool inCdcMode = false;
bool usbHidActive = false;
bool serialEnabled = false;
uint16_t usbButtonState = 0;
int16_t usbStickLX = 0, usbStickLY = 0;
int16_t usbStickRX = 0, usbStickRY = 0;
int usbMeterBars = -1;
int usbMeterNumBars = -1;

char screensaverBatteryText[6] = "";
int16_t screensaverBatteryTextW = 0;
int16_t screensaverBatteryTextH = 0;
int16_t screensaverBatteryW = 0;
int16_t screensaverBatteryH = 0;
int16_t screensaverBlockW = 0;
int16_t screensaverBlockH = 0;
bool screensaverBatteryVisible = false;
int screensaverLastLayoutPct = -2;  // Cache key for layout recalculation (-2 = never calculated)
bool screensaverLastLayoutBleStatus = false;

void initHidPressTiming();
int clampGameIndex(int game);
void refreshGameState(bool refreshOutputs);
void updateBluetoothMeter(int deviceBars, int numBars);
void updateUsbMeter(int bars, int numBars);
void logDeviceButtonPress(const char* context);
void syncRuntimeButtonStateAfterStartup();

#if defined(BOARD_LILYGO_T_QT_PRO)
void wakeDisplayHardware() {
  // Re-enable the backlight (active LOW) and wake the panel if it slept.
  gpio_hold_dis((gpio_num_t)TFT_BACKLIGHT_PIN);
  pinMode(TFT_BACKLIGHT_PIN, OUTPUT);
  digitalWrite(TFT_BACKLIGHT_PIN, LOW);
  if (display.panelWake()) {
    display.fillPanelBlack();
  }
}

// Blank the panel and cut the backlight. The backlight pin is held so it
// stays off through deep sleep (released again by wakeDisplayHardware).
void displayPanelOff() {
  display.panelSleep();
  digitalWrite(TFT_BACKLIGHT_PIN, HIGH);  // Active LOW: HIGH = off
  gpio_hold_en((gpio_num_t)TFT_BACKLIGHT_PIN);
}
#else
void wakeDisplayHardware() {
  // Sleep path disables the charge pump; explicitly restore it before drawing.
  display.ssd1306_command(SSD1306_DEACTIVATE_SCROLL_CMD);
  display.ssd1306_command(SSD1306_CHARGEPUMP);
  display.ssd1306_command(SSD1306_CHARGEPUMP_ENABLE);
  display.ssd1306_command(SSD1306_DISPLAYON);
  // Re-assert canonical panel mode to recover from occasional restart drift.
  display.ssd1306_command(SSD1306_DISPLAYALLON_RESUME_CMD);
  display.ssd1306_command(SSD1306_NORMALDISPLAY_CMD);
  display.ssd1306_command(SSD1306_SEGREMAP_DEFAULT);
  display.ssd1306_command(SSD1306_COMSCANDEC_CMD);
  display.ssd1306_command(SSD1306_SETDISPLAYOFFSET_CMD);
  display.ssd1306_command(0x00);
  display.ssd1306_command(SSD1306_SETSTARTLINE0_CMD);
  delay(2);  // SSD1306 charge pump stabilization
}

// Turn the panel off and disable the charge pump ahead of deep sleep.
void displayPanelOff() {
  display.ssd1306_command(SSD1306_DISPLAYOFF);
  display.ssd1306_command(SSD1306_CHARGEPUMP);
  display.ssd1306_command(SSD1306_CHARGEPUMP_DISABLE);
}
#endif

// ---------------------------------------------------------------------------
// USB XInput gamepad helpers
// ---------------------------------------------------------------------------
// Maintain shadow state; buttons are mapped from BLE constants to XInput bits.

void usbGamepadPress(uint16_t button) {
  #if HAS_USB_HID
  usbButtonState |= bleButtonToXInput(button);
  #endif
}

void usbGamepadRelease(uint16_t button) {
  #if HAS_USB_HID
  usbButtonState &= ~bleButtonToXInput(button);
  #endif
}

void usbGamepadSetLeftStick(int16_t x, int16_t y) {
  usbStickLX = x;
  usbStickLY = y;
}

void usbGamepadSetRightStick(int16_t x, int16_t y) {
  usbStickRX = x;
  usbStickRY = y;
}

void usbSendReport() {
  #if HAS_USB_HID
  if (!usbHidActive) return;
  usbGamepad.sendReport(usbButtonState, 0, 0,
                        usbStickLX, usbStickLY, usbStickRX, usbStickRY);
  #endif
}

void usbReleaseAll() {
  usbButtonState = 0;
  usbStickLX = 0; usbStickLY = 0;
  usbStickRX = 0; usbStickRY = 0;
  usbSendReport();
}

void initUsbHid() {
  #if HAS_USB_HID
  if (!USB_HID_ENABLED) {
    usbHidActive = false;
    return;
  }
  usbHidActive = true;
  // XInput descriptors are provided via TinyUSB callback overrides in
  // XboxHIDGamepad.h. USB.begin() ensures TinyUSB is started if CDC On
  // Boot did not already auto-start it.
  USB.begin();
  #endif
}

// ---------------------------------------------------------------------------
// CDC mode helpers (full-operation CDC mode with Serial enabled)
// ---------------------------------------------------------------------------

#if HAS_USB_HID
void exitCdcModeAndSleep() {
  if (USB_HID_ENABLED) {
    clearCdcModeFlag();  // Only return to XInput when it's actually enabled
  }
  display.clearDisplay();
  display.setTextSize(1);
  const char* msg = "Exiting CDC mode...";
  int16_t x1, y1; uint16_t w, h;
  display.getTextBounds(msg, 0, 0, &x1, &y1, &w, &h);
  display.setCursor((SCREEN_WIDTH - (int16_t)w) / 2, 28);
  display.print(msg);
  display.display();
  delay(1000);

  display.clearDisplay();
  display.display();
  displayPanelOff();

  #if defined(SENSOR_GBA_CARTRIDGE)
  cartEnd();
  #else
  Wire.end();
  pinMode(I2C_SDA_PIN, INPUT);
  pinMode(I2C_SCL_PIN, INPUT);
  #endif

  while (digitalRead(BUTTON_PIN) == LOW) delay(10);
  delay(250);  // Settle release bounce before arming a level-triggered wake

  // See enterDeepSleep(): the INPUT_PULLUP does not survive deep sleep, so the
  // wake pin must be pulled up under RTC control or ext0 fires immediately.
  rtc_gpio_pullup_en((gpio_num_t)BUTTON_PIN);
  rtc_gpio_pulldown_dis((gpio_num_t)BUTTON_PIN);

  esp_sleep_enable_ext0_wakeup((gpio_num_t)BUTTON_PIN, 0);
  if (serialEnabled) {
    Serial.println("Entering deep sleep from CDC mode...");
    Serial.flush();
  }
  esp_deep_sleep_start();
}

void enterCdcMode() {
  display.clearDisplay();
  display.setTextSize(1);
  const char* msg = "Restarting to CDC...";
  int16_t x1, y1; uint16_t w, h;
  display.getTextBounds(msg, 0, 0, &x1, &y1, &w, &h);
  display.setCursor((SCREEN_WIDTH - (int16_t)w) / 2, 28);
  display.print(msg);
  display.display();
  delay(1000);

  #if defined(SENSOR_GBA_CARTRIDGE)
  cartEnd();
  #else
  // Cleanly release I2C before software restart to avoid occasional
  // bus/display state glitches on the next boot.
  Wire.end();
  pinMode(I2C_SDA_PIN, INPUT_PULLUP);
  pinMode(I2C_SCL_PIN, INPUT_PULLUP);
  delay(2);
  #endif

  setCdcModeFlag();
  esp_restart();
}
#endif

// Why the chip booted, captured before anything can overwrite it. In XInput
// mode Serial is unavailable (usbHidActive), so this is surfaced on the
// power-on prompt instead: 2 = EXT0, a real button wake; 0 = UNDEFINED, i.e.
// a plain reset or crash rather than a wake.
esp_sleep_wakeup_cause_t bootWakeCause = ESP_SLEEP_WAKEUP_UNDEFINED;

void showHoldPowerOnPrompt() {
  wakeDisplayHardware();
  display.clearDisplay();
  display.setTextSize(1);
  display.setCursor(4, 28);
  display.print("Hold 2s to power on");
  if (DEBUG_SERIAL) {
    display.setCursor(4, 44);
    display.print("wake:");
    display.print((int)bootWakeCause);
  }
  display.display();
}

void logDeviceButtonPress(const char* context) {
  if (!serialEnabled) {
    return;
  }

  Serial.print("Device button pressed");
  if (context != nullptr && context[0] != '\0') {
    Serial.print(" (");
    Serial.print(context);
    Serial.print(")");
  }
  Serial.println();
}

// currentScreen persists in RTC memory across the deep-sleep wake reset, but
// currentGame does not - it is derived from the screen. Re-derive it here and
// reject any out-of-range stored value.
void restoreUiScreenAfterReset() {
  if (currentScreen < 0 || currentScreen >= NUM_UI_SCREENS) {
    currentScreen = 0;
  }
  if (currentScreen < NUM_GAMES) {
    currentGame = clampGameIndex(currentScreen);
  }
  uiScreenChanged = true;  // Force a draw of the restored screen
  if (serialEnabled) {
    Serial.print("Restored screen: ");
    Serial.print(currentScreen);
    Serial.print(" (game ");
    Serial.print(currentGame);
    Serial.println(")");
  }
}

void syncRuntimeButtonStateAfterStartup() {
  bool buttonPressed = (digitalRead(BUTTON_PIN) == LOW);
  buttonWasPressed = buttonPressed;
  if (buttonPressed) {
    buttonPressStart = millis();
    suppressShortPress = true;
  } else {
    buttonPressStart = 0;
    suppressShortPress = false;
  }
}

void setup() {
  bootWakeCause = esp_sleep_get_wakeup_cause();

  #if HAS_USB_HID
  inCdcMode = isXInputCdcMode();
  if (!inCdcMode && !USB_HID_ENABLED) {
    // USB HID disabled — auto-switch to CDC so Serial works.
    // Must restart once so the descriptor callbacks take effect.
    setCdcModeFlag();
    esp_restart();
  }
  #endif
  if (!inCdcMode) {
    initUsbHid();
  }
  serialEnabled = DEBUG_SERIAL && !usbHidActive;
  if (serialEnabled) {
    Serial.begin(115200);
    // Wait (up to 5s) for the host to open the CDC port; otherwise all
    // early boot prints are silently discarded by TinyUSB.
    unsigned long serialWaitStart = millis();
    while (!Serial && (millis() - serialWaitStart) < 5000UL) {
      delay(10);
    }
    Serial.println();
    #if defined(BOARD_LILYGO_T_QT_PRO)
    Serial.println("Ojo del Sol boot - board: LilyGO T-QT Pro");
    #else
    Serial.println("Ojo del Sol boot - board: Seeed XIAO ESP32S3");
    #endif
    // Why did we just boot? A wake cause of 2 (EXT0) immediately after a
    // long-press means deep sleep was entered and the button re-woke it.
    Serial.print("Wake cause: ");
    Serial.println((int)bootWakeCause);
  }
  initHidPressTiming();

  // Configure power button with internal pull-up (active LOW)
  pinMode(BUTTON_PIN, INPUT_PULLUP);
  if (BUTTON2_ENABLED && BUTTON2_PIN >= 0) {
    pinMode(BUTTON2_PIN, INPUT_PULLUP);
  }
  if (serialEnabled) {
    // LOW here on an EXT0 wake means the button was still held at wake time.
    Serial.print("Button level at boot - BTN_L: ");
    Serial.print(digitalRead(BUTTON_PIN));
    if (BUTTON2_ENABLED && BUTTON2_PIN >= 0) {
      Serial.print("  BTN_R: ");
      Serial.print(digitalRead(BUTTON2_PIN));
    }
    Serial.println();
  }

  restoreUiScreenAfterReset();

  if (GBA_LINK_ENABLED) {
    pinMode(GBA_PIN_SC, OUTPUT);
    pinMode(GBA_PIN_SD, OUTPUT);
    pinMode(GBA_PIN_SO, OUTPUT);
    digitalWrite(GBA_PIN_SC, LOW);
    digitalWrite(GBA_PIN_SD, LOW);
    digitalWrite(GBA_PIN_SO, LOW);
  }

  #if defined(SENSOR_GBA_CARTRIDGE)
  // Keep the cartridge unpowered and its bus floating through the power-on
  // prompt; cartBegin() below switches it on.
  cartEnd();
  #endif

  if (BATTERY_SENSE_ENABLED) {
    analogSetPinAttenuation(BAT_PIN, ADC_11db);
  }
  #if defined(SENSOR_LTR390)
  // Initialize I2C for the LTR390 (and, on the XIAO build, the OLED)
  Wire.begin(I2C_SDA_PIN, I2C_SCL_PIN);
  #endif

  #if defined(BOARD_LILYGO_T_QT_PRO)
  if (serialEnabled) Serial.println("Initializing display (Arduino_GFX / GC9107)...");
  // Release the backlight hold from a previous deep sleep before init.
  gpio_hold_dis((gpio_num_t)TFT_BACKLIGHT_PIN);
  bool displayOk = display.begin(TQT_DISPLAY_ROTATION);
  #else
  // Keep control of Wire pin config by skipping the library's internal
  // Wire.begin(); this improves consistency across software restarts.
  bool displayOk = display.begin(SSD1306_SWITCHCAPVCC, DISPLAY_I2C_ADDR, true, false);
  #endif
  if (!displayOk) {
    if (serialEnabled) Serial.println("Display init failed");
    delay(2000);
    #if HAS_USB_HID
    if (inCdcMode) clearCdcModeFlag();
    #endif
    enterDeepSleep();
  }
  displayInitialized = true;
  if (serialEnabled) Serial.println("Display initialized");

  display.clearDisplay();
  display.setTextColor(DISPLAY_WHITE);

  #if HAS_USB_HID
  // If the button is still held from the "enter CDC mode" long press,
  // require a release before allowing another long-press action.
  if (inCdcMode) {
    cdcRequireButtonRelease = (digitalRead(BUTTON_PIN) == LOW);
  }
  #endif

  display.setTextSize(1);
  int16_t ssX1, ssY1;
  uint16_t ssW, ssH;
  display.getTextBounds(SCREENSAVER_TEXT, 0, 0, &ssX1, &ssY1, &ssW, &ssH);
  screensaverTextW = (int16_t)ssW;
  screensaverTextH = (int16_t)ssH;
  screensaverTextX1 = ssX1;
  screensaverTextY1 = ssY1;
  calculateScreensaverLayout();
  screensaverLastLayoutPct = cachedBatteryPct;
  screensaverLastLayoutBleStatus = BLUETOOTH_ENABLED && (bleConnected || blePairingActive);
  if (!inCdcMode) {
    // Wait for power-on: show prompt for 10s, reset on button activity.
    // This always shows immediately so a short wake tap reliably shows the prompt.
    if (!waitForPowerOn()) {
      // Timed out - go back to sleep
      enterDeepSleep();
    }
  }
  // Re-assert charge pump and canonical panel state after any restart or power-on.
  // In CDC mode this recovers the display from drift caused by the software restart.
  // A double flush with a 10ms gap stabilizes the panel against occasional blank boots.
  wakeDisplayHardware();
  #if HAS_USB_HID
  if (inCdcMode) {
    display.clearDisplay();
    display.display();
    delay(50);
    display.clearDisplay();
    display.display();
  }
  #endif

  #if defined(SENSOR_GBA_CARTRIDGE)
  if (!cartBegin()) {
    if (serialEnabled) Serial.println("Cartridge tick timer could not be created; sleeping");
    display.clearDisplay();
    display.setTextSize(1);
    display.setCursor(10, 28);
    display.print("Cart timer failed");
    display.display();
    delay(2000);
    enterDeepSleep();
  }
  if (serialEnabled) {
    Serial.print("Cartridge sensor (UNTESTED): reading every ");
    Serial.print(CART_READ_INTERVAL_MS);
    Serial.print(" ms, calibration ");
    Serial.println(CART_CALIBRATION);
  }
  #else
  if (!initLTR390()) {
    if (serialEnabled) Serial.println("LTR390 not found - check wiring; sleeping");
    display.clearDisplay();
    display.setTextSize(1);
    display.setCursor(10, 28);
    display.print("LTR390 failed");
    display.display();
    delay(2000);
    enterDeepSleep();
  }

  // Configure LTR390 for UV sensing mode
  // Gain 18x: Datasheet reference setting for UVI sensitivity
  // Resolution 20-bit: Datasheet accuracy setting (~400ms integration)
  // Measurement rate 500ms: Matches datasheet example timing
  ltr.setMode(LTR390_MODE_UVS);
  ltr.setGain(LTR390_GAIN_18);
  ltr.setResolution(LTR390_RESOLUTION_20BIT);
  setMeasurementRate(MEAS_RATE_500MS);
  updateUvDivisorFromSensor();
  
  if (serialEnabled) {
    Serial.println("LTR390 configured: UV mode, 18x gain, 20-bit (~400ms)");
    Serial.println("Expected: ~2300 counts per UVI");
    if (UV_ENCLOSURE_COMP_ENABLED) {
      Serial.print("UV enclosure compensation: ON (T=");
      Serial.print(UV_ENCLOSURE_TRANSMITTANCE, 4);
      Serial.print(", offset=");
      Serial.print(UV_ENCLOSURE_UVI_OFFSET, 4);
      Serial.println(")");
    } else {
      Serial.println("UV enclosure compensation: OFF");
    }
  }
  #endif

  if (!inCdcMode) {
    // Show wake-up confirmation
    display.clearDisplay();
    display.setTextSize(1);
    const char wakeText[] = "Ojo del Sol ON";
    int16_t wakeX1, wakeY1;
    uint16_t wakeW, wakeH;
    display.getTextBounds(wakeText, 0, 0, &wakeX1, &wakeY1, &wakeW, &wakeH);
    const int16_t wakeGap = 8;
    int16_t blockW = SCREENSAVER_IMAGE_W + wakeGap + (int16_t)wakeW;
    int16_t blockH = (SCREENSAVER_IMAGE_H > (int16_t)wakeH) ? SCREENSAVER_IMAGE_H : (int16_t)wakeH;
    int16_t blockX = (SCREEN_WIDTH - blockW) / 2;
    int16_t blockY = (SCREEN_HEIGHT - blockH) / 2;
    int16_t iconX = blockX;
    int16_t iconY = blockY + ((blockH - SCREENSAVER_IMAGE_H) / 2);
    int16_t textX = blockX + SCREENSAVER_IMAGE_W + wakeGap;
    int16_t textY = blockY + ((blockH - (int16_t)wakeH) / 2);
    display.drawBitmap(iconX, iconY, OJO_DEL_SOL_BITMAP, SCREENSAVER_IMAGE_W, SCREENSAVER_IMAGE_H, DISPLAY_WHITE);
    display.setCursor(textX - wakeX1, textY - wakeY1);
    display.print(wakeText);
    display.display();
    delay(2000);
  }

  refreshGameState(false);
  lastScreenActivityMs = millis();
  #if HAS_USB_HID
  if (inCdcMode) {
    uiScreenChanged = true;  // Force initial display draw on first loop iteration
  }
  #endif
  initBluetooth();
  #if HAS_USB_HID
  if (!inCdcMode) {
    syncRuntimeButtonStateAfterStartup();
  }
  #else
  syncRuntimeButtonStateAfterStartup();
  #endif
}

void loop() {
  // Check power button for tap (change game) or long-press (sleep)
  handlePowerButton();
  handleSecondButton();
  updateScreensaverState();
  updateBluetoothState();
  updateBatteryStatus();
  handleLowBatteryCutoff();

  // Wait for new sensor data
  bool newData = false;
  #if defined(SENSOR_GBA_CARTRIDGE)
  if (cartPoll(&lastCartReading)) {
    hasCartReading = true;
    bool late = (CART_TICK_MAX_LATE_US > 0) && (lastCartReading.maxLateUs > CART_TICK_MAX_LATE_US);
    if (late) {
      // A delayed tick may have skewed the count; keep the previous level.
      cartLateReadings++;
    } else {
      // A reading that never saw the sensor flag counts as darkness (0 bars).
      cachedCartLevel = lastCartReading.ok ? getCartLevel(lastCartReading.raw) : 0;
      cachedNumBars = GAME_BARS[currentGame];
      cachedFilledBars = getCartBars(cachedCartLevel, currentGame);
      gameChanged = false;
      updateBluetoothMeter(cachedFilledBars, cachedNumBars);
      updateUsbMeter(cachedFilledBars, cachedNumBars);
    }
    if (serialEnabled && DEBUG_SERIAL_UV) {
      Serial.print("Cart raw: ");
      if (lastCartReading.ok) {
        Serial.print(lastCartReading.raw);
      } else {
        Serial.print("timeout");
      }
      Serial.print(" level: "); Serial.print(cachedCartLevel);
      Serial.print(" bus: "); Serial.print(lastCartReading.busOk ? "ok" : "FAIL");
      Serial.print(" ms: "); Serial.print(lastCartReading.durationMs);
      Serial.print(" late us: "); Serial.print(lastCartReading.maxLateUs);
      Serial.println(late ? " (discarded)" : "");
    }
    newData = true;
  }
  #else
  if (ltr.newDataAvailable()) {
    float uvi = calculateUVI();
    float uviForBars = UV_THRESHOLDS_CALIBRATED_OPEN_AIR ? uvi : cachedUviRaw;
    if (UVI_SMOOTHING_ENABLED) {
      if (!hasSmoothedUvi) {
        smoothedUvi = uviForBars;
        hasSmoothedUvi = true;
      } else {
        smoothedUvi = (UVI_SMOOTHING_ALPHA * uviForBars) + ((1.0f - UVI_SMOOTHING_ALPHA) * smoothedUvi);
      }
      uviForBars = smoothedUvi;
    }
    cachedNumBars = GAME_BARS[currentGame];
    if (gameChanged) {
      cachedFilledBars = getBoktaiBars(uviForBars, currentGame);
      gameChanged = false;
    } else {
      cachedFilledBars = getBoktaiBarsWithHysteresis(uviForBars, currentGame, cachedFilledBars);
    }
    cachedUvi = uviForBars;
    updateBluetoothMeter(cachedFilledBars, cachedNumBars);
    updateUsbMeter(cachedFilledBars, cachedNumBars);
    newData = true;
  }
  #endif

  updateGbaLinkOutput(cachedFilledBars);

  if (screensaverActive) {
    drawScreensaver();
  } else if (newData || screensaverJustExited || uiScreenChanged) {
    drawMainDisplay();
    uiScreenChanged = false;
  }

  screensaverJustExited = false;
  handleBlePresses();
  refreshSingleAnalogButton();
  delay(1); // Keep loop responsive while allowing accurate GBA phase timing
}

void noteScreenActivity() {
  lastScreenActivityMs = millis();
  if (screensaverActive) {
    screensaverActive = false;
    screensaverJustExited = true;
  }
}

bool shouldShowScreensaverBluetoothStatus() {
  return BLUETOOTH_ENABLED && (bleConnected || blePairingActive);
}

void calculateScreensaverLayout() {
  bool bluetoothStatusVisible = shouldShowScreensaverBluetoothStatus();
  screensaverBatteryVisible = (cachedBatteryPct >= 0) || bluetoothStatusVisible;
  screensaverBatteryText[0] = '\0';
  screensaverBatteryTextW = 0;
  screensaverBatteryTextH = 0;
  screensaverBatteryW = 0;
  screensaverBatteryH = 0;

  display.setTextSize(1);
  if (screensaverBatteryVisible) {
    bool hasBattery = (cachedBatteryPct >= 0);
    if (hasBattery) {
      snprintf(screensaverBatteryText, sizeof(screensaverBatteryText), "%d%%", cachedBatteryPct);
      int16_t x1, y1;
      uint16_t w, h;
      display.getTextBounds(screensaverBatteryText, 0, 0, &x1, &y1, &w, &h);
      screensaverBatteryTextW = (int16_t)w;
      screensaverBatteryTextH = (int16_t)h;
    }

    int16_t bluetoothW = 0;
    if (bluetoothStatusVisible) {
      bluetoothW = STATUS_BT_ICON_W;
    }

    if (hasBattery) {
      screensaverBatteryW = screensaverBatteryTextW + SCREENSAVER_BATT_GAP + STATUS_BATT_ICON_W;
      if (bluetoothStatusVisible) {
        screensaverBatteryW += bluetoothW + STATUS_BT_GAP;
      }
      screensaverBatteryH = max(screensaverBatteryTextH, STATUS_BATT_ICON_H);
    } else {
      screensaverBatteryW = bluetoothW;
      screensaverBatteryH = bluetoothW > 0 ? STATUS_BT_ICON_H : 0;
    }

    if (bluetoothStatusVisible) {
      screensaverBatteryH = max(screensaverBatteryH, STATUS_BT_ICON_H);
    }
  }

  screensaverBlockW = screensaverTextW;
  if (SCREENSAVER_IMAGE_W > screensaverBlockW) {
    screensaverBlockW = SCREENSAVER_IMAGE_W;
  }
  if (screensaverBatteryW > screensaverBlockW) {
    screensaverBlockW = screensaverBatteryW;
  }

  screensaverBlockH = SCREENSAVER_IMAGE_H + SCREENSAVER_IMAGE_TEXT_GAP + screensaverTextH;
  if (screensaverBatteryVisible) {
    screensaverBlockH += SCREENSAVER_TEXT_BATT_GAP + screensaverBatteryH;
  }
}

void drawScreensaverBattery(int16_t x, int16_t y) {
  if (!screensaverBatteryVisible) {
    return;
  }

  bool hasBattery = (cachedBatteryPct >= 0);
  bool bluetoothStatusVisible = shouldShowScreensaverBluetoothStatus();
  int16_t cursorX = x;

  display.setTextSize(1);
  if (bluetoothStatusVisible) {
    int16_t btY = y + ((screensaverBatteryH - STATUS_BT_ICON_H) / 2);
    drawBluetoothIcon(cursorX, btY, isBluetoothIconOn());
    cursorX += STATUS_BT_ICON_W;
    if (hasBattery) {
      cursorX += STATUS_BT_GAP;
    }
  }
  if (hasBattery) {
    int16_t textY = y + ((screensaverBatteryH - screensaverBatteryTextH) / 2);
    display.setCursor(cursorX, textY);
    display.print(screensaverBatteryText);
    cursorX += screensaverBatteryTextW + SCREENSAVER_BATT_GAP;

    int16_t iconY = y + ((screensaverBatteryH - STATUS_BATT_ICON_H) / 2);
    drawBatteryGauge(cursorX, iconY, cachedBatteryPct);
  }
}

void updateScreensaverState() {
  if (!SCREENSAVER_ENABLED) {
    return;
  }
  if (screensaverActive) {
    return;
  }

  unsigned long now = millis();
  if ((now - lastScreenActivityMs) >= SCREENSAVER_TIMEOUT_MS) {
    screensaverActive = true;
    screensaverDx = 1;
    screensaverDy = 1;
    calculateScreensaverLayout();
    screensaverLastLayoutPct = cachedBatteryPct;
    screensaverLastLayoutBleStatus = shouldShowScreensaverBluetoothStatus();
    screensaverX = (SCREEN_WIDTH - screensaverBlockW) / 2;
    screensaverY = (SCREEN_HEIGHT - screensaverBlockH) / 2;
    lastScreensaverMoveMs = 0;
  }
}

void drawScreensaver() {
  unsigned long now = millis();
  if ((now - lastScreensaverMoveMs) < SCREENSAVER_MOVE_MS) {
    return;
  }
  lastScreensaverMoveMs = now;

  bool bluetoothStatusVisible = shouldShowScreensaverBluetoothStatus();
  if (screensaverLastLayoutPct != cachedBatteryPct ||
      screensaverLastLayoutBleStatus != bluetoothStatusVisible) {
    calculateScreensaverLayout();
    screensaverLastLayoutPct = cachedBatteryPct;
    screensaverLastLayoutBleStatus = bluetoothStatusVisible;
  }

  int16_t maxX = SCREEN_WIDTH - screensaverBlockW;
  int16_t maxY = SCREEN_HEIGHT - screensaverBlockH;
  if (maxX < 0) {
    maxX = 0;
  }
  if (maxY < 0) {
    maxY = 0;
  }

  screensaverX += screensaverDx;
  screensaverY += screensaverDy;

  if (screensaverX <= 0) {
    screensaverX = 0;
    screensaverDx = 1;
  } else if (screensaverX >= maxX) {
    screensaverX = maxX;
    screensaverDx = -1;
  }

  if (screensaverY <= 0) {
    screensaverY = 0;
    screensaverDy = 1;
  } else if (screensaverY >= maxY) {
    screensaverY = maxY;
    screensaverDy = -1;
  }

  display.clearDisplay();

  int16_t imageX = screensaverX + ((screensaverBlockW - SCREENSAVER_IMAGE_W) / 2);
  int16_t imageY = screensaverY;
  display.drawBitmap(imageX, imageY, OJO_DEL_SOL_BITMAP, SCREENSAVER_IMAGE_W, SCREENSAVER_IMAGE_H, DISPLAY_WHITE);

  int16_t textX = screensaverX + ((screensaverBlockW - screensaverTextW) / 2);
  int16_t textY = imageY + SCREENSAVER_IMAGE_H + SCREENSAVER_IMAGE_TEXT_GAP;
  display.setTextSize(1);
  display.setCursor(textX - screensaverTextX1, textY - screensaverTextY1);
  display.print(SCREENSAVER_TEXT);

  if (screensaverBatteryVisible) {
    int16_t batteryX = screensaverX + ((screensaverBlockW - screensaverBatteryW) / 2);
    int16_t batteryY = textY + screensaverTextH + SCREENSAVER_TEXT_BATT_GAP;
    drawScreensaverBattery(batteryX, batteryY);
  }

  display.display();
}

void drawDebugDisplay() {
  display.clearDisplay();

  // Draw Status Icons (Top Right)
  drawStatusIcons();

  display.setTextSize(1);
  display.setCursor(0, 0);
  #if HAS_USB_HID
  display.print(inCdcMode ? "CDC" : "XInput");
  #else
  display.print("DEBUG");
  #endif

  #if defined(SENSOR_GBA_CARTRIDGE)
  // Cartridge readings. "Raw" with the sensor covered, minus 2, is the
  // suggested CART_CALIBRATION (see config.h). "Late" is the latest reading's most delayed tick;
  // "Rej" counts readings discarded for exceeding CART_TICK_MAX_LATE_US.
  display.setCursor(0, 10);
  display.print("Raw:");
  if (!hasCartReading) {
    display.print("--");
  } else if (lastCartReading.ok) {
    display.print(lastCartReading.raw);
  } else {
    display.print("timeout");
  }
  display.print(" Lvl:");
  display.print(cachedCartLevel);

  display.setCursor(0, 20);
  display.print("Bus:");
  if (hasCartReading) {
    display.print(lastCartReading.busOk ? "ok " : "FAIL ");
    display.print(lastCartReading.durationMs);
    display.print("ms");
  } else {
    display.print("--");
  }

  display.setCursor(0, 30);
  display.print("Late:");
  display.print(hasCartReading ? lastCartReading.maxLateUs : 0);
  display.print("us Rej:");
  display.print(cartLateReadings);
  #else
  // UV readings
  display.setCursor(0, 10);
  display.print("UV raw:");
  display.print(cachedRawUVS);

  display.setCursor(0, 20);
  display.print("UVI:");
  display.print(cachedUviRaw, 3);

  display.setCursor(0, 30);
  display.print("UVI comp'ed:");
  display.print(cachedUvi, 3);
  #endif

  // Battery readings
  bool haveBatteryReading = BATTERY_SENSE_ENABLED && hasBatteryReading;

  display.setCursor(0, 42);
  display.print("ADC avg:");
  if (haveBatteryReading) {
    display.print(cachedBatteryAdcAvg, 0);
  } else {
    display.print("N/A");
  }

  display.setCursor(0, 52);
  display.print("Batt V:");
  if (haveBatteryReading) {
    display.print(cachedBatteryVoltage, 2);
  } else {
    display.print("N/A");
  }

  display.display();
}

void drawMainDisplay() {
  if (currentScreen == DEBUG_SCREEN_INDEX) {
    drawDebugDisplay();
    return;
  }

  display.clearDisplay();

  // 1. Draw Status Icons (Top Right)
  drawStatusIcons();

  // 2. Game Name
  display.setTextSize(1);
  display.setCursor(0, 0);
  display.print(GAME_NAMES[currentGame]);

  // 3. Bar Count (Large, Prominent)
  display.setTextSize(3);
  display.setCursor(0, 10);
  display.print(cachedFilledBars);

  // 4. Sensor reading (Small, Secondary): UV Index, or the cartridge level
  display.setTextSize(1);
  display.setCursor(64, 18);
  #if defined(SENSOR_GBA_CARTRIDGE)
  if (!hasCartReading) {
    display.print("Level:--");
  } else if (lastCartReading.ok) {
    display.print("Level:");
    display.print(cachedCartLevel);
  } else {
    display.print("No cart");
  }
  #else
  display.print(UV_ENCLOSURE_COMP_ENABLED ? "cUVI:" : "UVI:");
  display.print(cachedUvi, 3);
  #endif

  // 5. Draw Sun Gauge (8 or 10 segments depending on game)
  drawBoktaiGauge(38, 20, cachedFilledBars, cachedNumBars);

  display.display();
}

void updateGbaLinkOutput(int bars) {
  if (!GBA_LINK_ENABLED) {
    return;
  }

  uint8_t value = (uint8_t)constrain(bars, 0, 15);  // 4-bit bar value encoded over two phases

  // Framed 3-wire mode:
  // - SC carries frame phase (0 = low pair, 1 = high pair)
  // - SD/SO carry two data bits for that phase
  // - SI is unused (wired to ground externally)
  unsigned long phaseIntervalUs = GBA_LINK_FRAME_TOGGLE_MS * 1000UL;
  if (phaseIntervalUs == 0) {
    phaseIntervalUs = 1000UL;  // Guard against invalid config value
  }

  unsigned long nowUs = micros();
  if (gbaFrameLastToggleUs == 0) {
    gbaFramePhaseHigh = !gbaFramePhaseHigh;
    gbaFrameLastToggleUs = nowUs;
  } else {
    unsigned long elapsedUs = nowUs - gbaFrameLastToggleUs;
    if (elapsedUs >= phaseIntervalUs) {
      unsigned long toggles = elapsedUs / phaseIntervalUs;
      if ((toggles & 1UL) != 0) {
        gbaFramePhaseHigh = !gbaFramePhaseHigh;
      }
      gbaFrameLastToggleUs += toggles * phaseIntervalUs;
    }
  }

  uint8_t pair = gbaFramePhaseHigh ? ((value >> 2) & 0x03) : (value & 0x03);
  bool soBit = (pair & 0x01) != 0;
  bool sdBit = (pair & 0x02) != 0;

  // Data pins first so they're stable before SC signals the new phase
  digitalWrite(GBA_PIN_SD, sdBit ? HIGH : LOW);
  digitalWrite(GBA_PIN_SO, soBit ? HIGH : LOW);
  digitalWrite(GBA_PIN_SC, gbaFramePhaseHigh ? HIGH : LOW);
}

#if defined(SENSOR_LTR390)
void writeLtr390Register(uint8_t reg, uint8_t value) {
  Wire.beginTransmission(LTR390_I2CADDR_DEFAULT);
  Wire.write(reg);
  Wire.write(value);
  Wire.endTransmission();
}

void setMeasurementRate(uint8_t rate) {
  uint8_t resBits = (uint8_t)ltr.getResolution();
  uint8_t regValue = (uint8_t)((resBits << 4) | (rate & 0x07));
  writeLtr390Register(LTR390_MEAS_RATE, regValue);
}

float gainToFactor(ltr390_gain_t gain) {
  switch (gain) {
    case LTR390_GAIN_1: return 1.0f;
    case LTR390_GAIN_3: return 3.0f;
    case LTR390_GAIN_6: return 6.0f;
    case LTR390_GAIN_9: return 9.0f;
    case LTR390_GAIN_18: return 18.0f;
    default: return 1.0f;
  }
}

float resolutionToIntegrationMs(ltr390_resolution_t res) {
  switch (res) {
    case LTR390_RESOLUTION_20BIT: return 400.0f;
    case LTR390_RESOLUTION_19BIT: return 200.0f;
    case LTR390_RESOLUTION_18BIT: return 100.0f;
    case LTR390_RESOLUTION_17BIT: return 50.0f;
    case LTR390_RESOLUTION_16BIT: return 25.0f;
    case LTR390_RESOLUTION_13BIT: return 12.5f;
    default: return 100.0f;
  }
}

void updateUvDivisorFromSensor() {
  float gainFactor = gainToFactor(ltr.getGain());
  float intMs = resolutionToIntegrationMs(ltr.getResolution());

  if (gainFactor <= 0.0f || intMs <= 0.0f) {
    uvDivisor = UV_SENSITIVITY_COUNTS_PER_UVI;
  } else {
    uvDivisor = (UV_SENSITIVITY_COUNTS_PER_UVI * gainFactor * intMs) /
                (UV_REFERENCE_GAIN * UV_REFERENCE_INT_MS);
  }

  if (serialEnabled) {
    Serial.print("UV divisor: ");
    Serial.println(uvDivisor, 4);
  }
}
#endif

float applyEnclosureCompensation(float measuredUvi) {
  if (!UV_ENCLOSURE_COMP_ENABLED) {
    return measuredUvi;
  }
  if (UV_ENCLOSURE_TRANSMITTANCE <= 0.0f) {
    return measuredUvi;
  }

  float corrected = (measuredUvi - UV_ENCLOSURE_UVI_OFFSET) / UV_ENCLOSURE_TRANSMITTANCE;
  if (corrected < 0.0f) {
    corrected = 0.0f;
  }
  return corrected;
}

// Raphi's original Boktai cartridge bar thresholds (raphi.xyz/~raphi/boktai/sensor_graph/).
// Ratios of the UV range [UV_MIN, UV_SATURATION] at which each bar level starts.
// Derived from exclusive upper bounds on the 0-140 cartridge scale: ratio = (upper_bound - 1) / 139.
// Boktai 1 (8 bars): exclusive upper bounds 1, 7, 16, 28, 44, 67, 98, 140
static const float RAPHI_B1[8] = {
  0.0f,          // Bar 1: starts at UV_MIN
  6.0f/139.0f,   // Bar 2
  15.0f/139.0f,  // Bar 3
  27.0f/139.0f,  // Bar 4
  43.0f/139.0f,  // Bar 5
  66.0f/139.0f,  // Bar 6
  97.0f/139.0f,  // Bar 7
  1.0f           // Bar 8: starts at UV_SATURATION
};
// Boktai 2 & 3 (10 bars): exclusive upper bounds 1, 6, 13, 23, 35, 50, 67, 87, 110, 140
static const float RAPHI_B23[10] = {
  0.0f,           // Bar 1: starts at UV_MIN
  5.0f/139.0f,    // Bar 2
  12.0f/139.0f,   // Bar 3
  22.0f/139.0f,   // Bar 4
  34.0f/139.0f,   // Bar 5
  49.0f/139.0f,   // Bar 6
  66.0f/139.0f,   // Bar 7
  86.0f/139.0f,   // Bar 8
  109.0f/139.0f,  // Bar 9
  1.0f            // Bar 10: starts at UV_SATURATION
};

const float* getRaphiRatios(int numBars) {
  return (numBars == 8) ? RAPHI_B1 : RAPHI_B23;
}

void getGameUvRange(int game, float* uvMin, float* uvSat) {
  if (AUTO_MODE) {
    *uvMin = AUTO_UV_MIN;
    *uvSat = AUTO_UV_SATURATION;
    return;
  }
  switch (game) {
    case 0: *uvMin = BOKTAI_1_UV_MIN; *uvSat = BOKTAI_1_UV_SATURATION; break;
    case 1: *uvMin = BOKTAI_2_UV_MIN; *uvSat = BOKTAI_2_UV_SATURATION; break;
    case 2: *uvMin = BOKTAI_3_UV_MIN; *uvSat = BOKTAI_3_UV_SATURATION; break;
    default: *uvMin = AUTO_UV_MIN;    *uvSat = AUTO_UV_SATURATION;      break;
  }
}

int clampGameIndex(int game) {
  if (game < 0) {
    return 0;
  }
  if (game >= NUM_GAMES) {
    return NUM_GAMES - 1;
  }
  return game;
}

float getBarThreshold(int game, int barIndex) {
  game = clampGameIndex(game);
  int numBars = GAME_BARS[game];
  if (barIndex < 1) barIndex = 1;
  if (barIndex > numBars) barIndex = numBars;
  float uvMin, uvSat;
  getGameUvRange(game, &uvMin, &uvSat);
  if (uvSat <= uvMin) return uvMin;
  return uvMin + getRaphiRatios(numBars)[barIndex - 1] * (uvSat - uvMin);
}

int getBoktaiBarsWithHysteresis(float uvi, int game, int lastBars) {
  game = clampGameIndex(game);
  int numBars = GAME_BARS[game];
  int target = getBoktaiBars(uvi, game);

  if (!BAR_HYSTERESIS_ENABLED || BAR_HYSTERESIS <= 0.0f || (AUTO_MODE && AUTO_UV_SATURATION <= AUTO_UV_MIN)) {
    return target;
  }

  if (lastBars < 0) {
    lastBars = 0;
  }
  if (lastBars > numBars) {
    lastBars = numBars;
  }

  if (target > lastBars) {
    float upThreshold = getBarThreshold(game, lastBars + 1);
    if (uvi >= (upThreshold + BAR_HYSTERESIS)) {
      return target;
    }
    return lastBars;
  }

  if (target < lastBars) {
    // lastBars > 0 guaranteed: clamped to [0, numBars] above and target < lastBars
    float downThreshold = getBarThreshold(game, lastBars);
    if (uvi < (downThreshold - BAR_HYSTERESIS)) {
      return target;
    }
    return lastBars;
  }

  return lastBars;
}

// Convert UV Index to Boktai bar count based on selected game
int getBoktaiBars(float uvi, int game) {
  game = clampGameIndex(game);
  int numBars = GAME_BARS[game];
  float uvMin, uvSat;
  getGameUvRange(game, &uvMin, &uvSat);

  if (uvSat <= uvMin) {
    return (uvi >= uvMin) ? numBars : 0;
  }
  if (uvi < uvMin) return 0;
  if (uvi >= uvSat) return numBars;

  // Scale UVI to [0, 1) within the configured range and look up in Raphi's table.
  // Bar N+1 starts where bar N's exclusive upper bound falls (ratio = (upper_bound-1)/139).
  float ratio = (uvi - uvMin) / (uvSat - uvMin);
  const float* ratios = getRaphiRatios(numBars);
  for (int i = numBars - 1; i >= 0; i--) {
    if (ratio >= ratios[i]) {
      return i + 1;
    }
  }
  return 0;
}

#if defined(SENSOR_GBA_CARTRIDGE)
// Cartridge sensor: the games' own bar tables, as the first 0-140 level at
// which each bar starts. Boktai 1 (J/U) and 2/3 are Raphi's tables above;
// Boktai 1 (E) was found by disassembling that ROM (see the README).
static const uint8_t CART_BARS_B1[8] = { 1, 7, 16, 28, 44, 67, 98, 140 };
static const uint8_t CART_BARS_B1_EUROPE[8] = { 1, 7, 15, 25, 38, 56, 98, 140 };
static const uint8_t CART_BARS_B23[10] = { 1, 6, 13, 23, 35, 50, 67, 87, 110, 140 };

// Convert a raw cartridge reading to the game's 0-140 level
int getCartLevel(uint16_t raw) {
  return constrain(CART_CALIBRATION - (int)raw, 0, 140);
}

// Convert a cartridge level to Boktai bar count based on selected game
int getCartBars(int level, int game) {
  game = clampGameIndex(game);
  int numBars = GAME_BARS[game];
  const uint8_t* table = CART_BARS_B23;
  if (numBars == 8) {
    table = CART_BOKTAI1_EUROPE_TABLE ? CART_BARS_B1_EUROPE : CART_BARS_B1;
  }
  int bars = 0;
  for (int i = 0; i < numBars; i++) {
    if (level >= table[i]) {
      bars++;
    }
  }
  return bars;
}
#endif

void refreshGameState(bool refreshOutputs) {
  currentGame = clampGameIndex(currentGame);
  cachedNumBars = GAME_BARS[currentGame];
  #if defined(SENSOR_GBA_CARTRIDGE)
  cachedFilledBars = getCartBars(cachedCartLevel, currentGame);
  #else
  cachedFilledBars = getBoktaiBars(cachedUvi, currentGame);
  #endif

  if (refreshOutputs) {
    updateBluetoothMeter(cachedFilledBars, cachedNumBars);
    updateUsbMeter(cachedFilledBars, cachedNumBars);
  }
}

// Advance the UI screen by step (+1 forward, -1 backward), updating game
// state when a game screen is selected.
void cycleUiScreen(int step) {
  currentScreen = (currentScreen + NUM_UI_SCREENS + step) % NUM_UI_SCREENS;
  uiScreenChanged = true;

  if (currentScreen < NUM_GAMES) {
    currentGame = clampGameIndex(currentScreen);
    gameChanged = true;
    hidGameChanged = true;
    refreshGameState(true);
  }
}

// Handle power button: tap to cycle screens, long-press (2s) to sleep
void handlePowerButton() {
  #if HAS_USB_HID
  if (cdcRequireButtonRelease) {
    if (digitalRead(BUTTON_PIN) != LOW) {
      cdcRequireButtonRelease = false;
      buttonWasPressed = false;
    }
    return;
  }
  #endif

  bool buttonPressed = (digitalRead(BUTTON_PIN) == LOW);

  if (buttonPressed && !buttonWasPressed) {
    logDeviceButtonPress("runtime");
    buttonPressStart = millis();
    buttonWasPressed = true;
    if (screensaverActive) {
      suppressShortPress = true;
    }
    noteScreenActivity();
  }
  else if (buttonPressed && buttonWasPressed) {
    noteScreenActivity();
    if ((millis() - buttonPressStart) >= LONG_PRESS_MS) {
      if (serialEnabled) {
        Serial.print("BTN_L long-press fired after ");
        Serial.print(millis() - buttonPressStart);
        Serial.print("ms - inCdcMode=");
        #if HAS_USB_HID
        Serial.print(inCdcMode ? 1 : 0);
        #else
        Serial.print("n/a");
        #endif
        Serial.print(" screen=");
        Serial.print(currentScreen);
        Serial.print("/debug=");
        Serial.println(DEBUG_SCREEN_INDEX);
        Serial.flush();
      }
      #if HAS_USB_HID
      if (inCdcMode) {
        if (USB_HID_ENABLED) {
          exitCdcModeAndSleep();  // Return to XInput mode
        } else {
          enterDeepSleep();       // USB disabled — just sleep normally
        }
      } else if (currentScreen == DEBUG_SCREEN_INDEX) {
        enterCdcMode();
      } else {
        enterDeepSleep();
      }
      #else
      enterDeepSleep();
      #endif
    }
  }
  else if (!buttonPressed && buttonWasPressed) {
    unsigned long pressDuration = millis() - buttonPressStart;
    if (pressDuration >= DEBOUNCE_MS && pressDuration < LONG_PRESS_MS) {
      if (!suppressShortPress) {
        cycleUiScreen(BUTTON_TAP_STEP);
      }
    }
    suppressShortPress = false;
    buttonWasPressed = false;
  }
}

// Handle the secondary button (T-QT BTN_R): tap cycles screens (direction
// set by BUTTON2_TAP_STEP). No long-press action; it cannot wake the device
// from deep sleep.
void handleSecondButton() {
  if (!BUTTON2_ENABLED || BUTTON2_PIN < 0) {
    return;
  }

  bool buttonPressed = (digitalRead(BUTTON2_PIN) == LOW);

  if (buttonPressed && !button2WasPressed) {
    logDeviceButtonPress("runtime, button 2");
    button2PressStart = millis();
    button2WasPressed = true;
    if (screensaverActive) {
      button2SuppressShortPress = true;
    }
    noteScreenActivity();
  }
  else if (buttonPressed && button2WasPressed) {
    noteScreenActivity();
  }
  else if (!buttonPressed && button2WasPressed) {
    unsigned long pressDuration = millis() - button2PressStart;
    // Bounded like the power button: a deliberate long hold is not a tap, so
    // it must not silently change the screen on release.
    if (pressDuration >= DEBOUNCE_MS && pressDuration < LONG_PRESS_MS &&
        !button2SuppressShortPress) {
      cycleUiScreen(BUTTON2_TAP_STEP);
    }
    button2SuppressShortPress = false;
    button2WasPressed = false;
  }
}

// Wait for power-on with 10-second timeout.
// Always shows "Hold 2s to power on" immediately so wake taps are visible.
// Button activity resets the 10-second timer.
// Returns true if hold completed, false if timed out.
bool waitForPowerOn() {
  const unsigned long DISPLAY_TIMEOUT_MS = 10000;  // 10 seconds
  unsigned long lastActivity = millis();
  unsigned long lastPromptRefresh = lastActivity;
  unsigned long pressStart = 0;
  bool wasPressed = false;
  bool pressedAtStart = (digitalRead(BUTTON_PIN) == LOW);
  
  showHoldPowerOnPrompt();
  if (pressedAtStart) {
    logDeviceButtonPress("wake");
    pressStart = lastActivity;
    wasPressed = true;
  }
  
  while (true) {
    bool pressed = (digitalRead(BUTTON_PIN) == LOW);
    unsigned long now = millis();
    
    // Check for timeout (10 seconds of no button activity)
    if ((now - lastActivity) >= DISPLAY_TIMEOUT_MS) {
      displayPanelOff();
      return false;  // Timed out - caller should go to sleep
    }
    
    // Button just pressed
    if (pressed && !wasPressed) {
      logDeviceButtonPress("wake");
      lastActivity = now;  // Reset timeout
      pressStart = now;
      wasPressed = true;
      
      // Refresh prompt on each press.
      showHoldPowerOnPrompt();
      lastPromptRefresh = now;
    }
    // Button held
    else if (pressed && wasPressed) {
      lastActivity = now;  // Reset timeout while holding
      // Retry prompt draw periodically while held in case the first draw was missed.
      if ((now - lastPromptRefresh) >= 750UL) {
        showHoldPowerOnPrompt();
        lastPromptRefresh = now;
      }
      
      if ((now - pressStart) >= LONG_PRESS_MS) {
        return true;  // Successfully powered on
      }
    }
    // Button released
    else if (!pressed && wasPressed) {
      wasPressed = false;
    }
    
    delay(10);
  }
}

// Enter deep sleep mode with button wake-up
void enterDeepSleep() {
  if (serialEnabled) {
    Serial.println("enterDeepSleep() - entered");
    Serial.flush();
  }

  // Release USB HID state before sleep
  usbReleaseAll();

  // Quiesce Bluetooth before sleep.
  //
  // Do NOT free the BLE objects here. compositeHID (a global) retains the
  // xboxGamepad pointer from addDevice(), and XboxGamepadDevice holds
  // NimBLECharacteristic pointers owned by the NimBLE stack. Calling
  // NimBLEDevice::deinit(true) and then deleting the device ran its destructor
  // over memory the stack had already released, which reset the chip before it
  // ever reached esp_deep_sleep_start(). Deep sleep powers the radio down and
  // resets the whole chip on wake, so there is no heap worth reclaiming.
  if (BLUETOOTH_ENABLED && xboxGamepad != nullptr) {
    // Release any held buttons/sticks so the host does not see them stuck.
    if (compositeHID.isConnected()) {
      if (bleActiveButton != 0) {
        xboxGamepad->release(bleActiveButton);
      }
      if (HID_METER_UNLOCK_BUTTON_ENABLED && bleSingleAnalogButtonHeld) {
        xboxGamepad->release(HID_METER_UNLOCK_BUTTON);
      }
      xboxGamepad->release(XBOX_BUTTON_LS);
      xboxGamepad->release(XBOX_BUTTON_RS);
      xboxGamepad->setLeftThumb(0, 0);
      xboxGamepad->setRightThumb(0, 0);
      xboxGamepad->sendGamepadReport();
    }
    stopBleAdvertising();
    delay(100);  // Let the stack flush before the radio goes down
  }
  if (serialEnabled) {
    Serial.println("enterDeepSleep() - BLE quiesced");
    Serial.flush();
  }

  // Turn off display
  if (displayInitialized) {
    display.clearDisplay();
    display.display();
    displayPanelOff();
  }
  if (serialEnabled) {
    Serial.println("enterDeepSleep() - display off");
    Serial.flush();
  }

  #if defined(SENSOR_GBA_CARTRIDGE)
  // Stop any reading and float the cartridge bus
  cartEnd();
  #else
  // Release I2C lines to reduce back-powering during sleep
  Wire.end();
  pinMode(I2C_SDA_PIN, INPUT);
  pinMode(I2C_SCL_PIN, INPUT);
  #endif

  // Set GBA link pins to high-impedance
  if (GBA_LINK_ENABLED) {
    pinMode(GBA_PIN_SC, INPUT);
    pinMode(GBA_PIN_SD, INPUT);
    pinMode(GBA_PIN_SO, INPUT);
  }

  // Set battery sense pin to INPUT (disable ADC pull)
  if (BATTERY_SENSE_ENABLED) {
    pinMode(BAT_PIN, INPUT);
  }
  
  if (serialEnabled) {
    Serial.println("enterDeepSleep() - waiting for button release...");
    Serial.flush();
  }

  // Wait for a settled release before arming the wake source. A brief
  // release-bounce back to LOW after ext0 is armed wakes the chip instantly,
  // which reads as "it never slept". Require the pin to stay HIGH for
  // RELEASE_SETTLE_MS continuously, but give up after RELEASE_WAIT_MAX_MS so a
  // stuck or held button can never hang here forever.
  const unsigned long RELEASE_SETTLE_MS = 250;
  const unsigned long RELEASE_WAIT_MAX_MS = 10000;
  unsigned long releaseWaitStart = millis();
  unsigned long highSince = 0;
  while ((millis() - releaseWaitStart) < RELEASE_WAIT_MAX_MS) {
    if (digitalRead(BUTTON_PIN) == LOW) {
      highSince = 0;  // Still pressed (or bounced back) - restart the settle
    } else {
      if (highSince == 0) {
        highSince = millis();
      } else if ((millis() - highSince) >= RELEASE_SETTLE_MS) {
        break;
      }
    }
    delay(10);
  }

  // Hold the wake pin high through sleep. pinMode(INPUT_PULLUP) does not
  // survive deep sleep: the pad is switched to RTC control and the digital
  // pull-up is dropped, so an unpulled pin floats and ext0's level-0 trigger
  // fires immediately. This must be set on every sleep entry.
  rtc_gpio_pullup_en((gpio_num_t)BUTTON_PIN);
  rtc_gpio_pulldown_dis((gpio_num_t)BUTTON_PIN);

  // Configure wake-up source: BUTTON_PIN going LOW (pressed)
  esp_sleep_enable_ext0_wakeup((gpio_num_t)BUTTON_PIN, 0);

  if (serialEnabled) {
    Serial.print("Entering deep sleep... BTN_L level=");
    Serial.println(digitalRead(BUTTON_PIN));
    Serial.flush();
  }
  
  // Enter deep sleep - device resets on wake
  esp_deep_sleep_start();
}

// Draw Boktai-style segmented sun gauge (8 or 10 segments)
void drawBoktaiGauge(int y, int h, int filledBars, int totalBars) {
  if (totalBars <= 0) {
    return;
  }

  int barWidth = SCREEN_WIDTH - 4;  // Target gauge width (keeps side margins)
  int gap = 2;
  int segW = (barWidth - (gap * (totalBars - 1))) / totalBars;
  if (segW < 1) {
    segW = 1;
  }
  int usedWidth = (segW * totalBars) + (gap * (totalBars - 1));
  int xStart = (SCREEN_WIDTH - usedWidth) / 2;

  for (int i = 0; i < totalBars; i++) {
    int x = xStart + (i * (segW + gap));
    if (i < filledBars) {
      display.fillRect(x, y, segW, h, DISPLAY_WHITE); // Filled segment
    } else {
      display.drawRect(x, y, segW, h, DISPLAY_WHITE); // Outline segment
    }
  }
}

bool isBluetoothIconOn() {
  if (!BLUETOOTH_ENABLED) {
    return false;
  }
  if (bleConnected) {
    return true;
  }
  if (blePairingActive) {
    return bleIconFlashOn;
  }
  return false;
}

void drawBluetoothIcon(int x, int y, bool on) {
  if (!on) {
    return;
  }

  display.drawLine(x + 3, y, x + 3, y + (STATUS_BT_ICON_H - 1), DISPLAY_WHITE);
  display.drawLine(x + 3, y, x + 7, y + 2, DISPLAY_WHITE);
  display.drawLine(x + 3, y + 4, x + 7, y + 2, DISPLAY_WHITE);
  display.drawLine(x + 3, y + 4, x + 7, y + 6, DISPLAY_WHITE);
  display.drawLine(x + 3, y + (STATUS_BT_ICON_H - 1), x + 7, y + 6, DISPLAY_WHITE);
  display.drawLine(x + 3, y + 4, x, y + 2, DISPLAY_WHITE);
  display.drawLine(x + 3, y + 4, x, y + 6, DISPLAY_WHITE);
}

void drawBatteryGauge(int x, int y, int pct) {
  int16_t bodyW = STATUS_BATT_ICON_W - 2;
  display.drawRect(x, y, bodyW, STATUS_BATT_ICON_H, DISPLAY_WHITE); // Main body
  display.fillRect(x + bodyW, y + 2, 2, STATUS_BATT_ICON_H - 4, DISPLAY_WHITE); // Tip

  int fillW = (pct * (bodyW - 4)) / 100;
  display.fillRect(x + 2, y + 2, fillW, STATUS_BATT_ICON_H - 4, DISPLAY_WHITE);
}

void drawStatusIcons() {
  bool batteryVisible = (cachedBatteryPct >= 0);
  bool btReserved = BLUETOOTH_ENABLED;
  bool btOn = isBluetoothIconOn();

  int16_t batteryX = SCREEN_WIDTH - STATUS_BATT_ICON_W - STATUS_RIGHT_MARGIN;
  int16_t batteryY = 2;
  int16_t btY = batteryY - 1;
  int16_t textX = 0;

  if (batteryVisible) {
    char pctText[6];
    snprintf(pctText, sizeof(pctText), "%d%%", cachedBatteryPct);
    int16_t x1, y1;
    uint16_t w, h;
    display.setTextSize(1);
    display.getTextBounds(pctText, 0, 0, &x1, &y1, &w, &h);
    textX = batteryX - STATUS_TEXT_GAP - (int16_t)w;
    int16_t textY = batteryY + ((STATUS_BATT_ICON_H - (int16_t)h) / 2);
    display.setCursor(textX, textY);
    display.print(pctText);
    drawBatteryGauge(batteryX, batteryY, cachedBatteryPct);
  }

  if (btReserved) {
    int16_t drawX = 0;
    if (batteryVisible) {
      drawX = textX - STATUS_BT_GAP - STATUS_BT_ICON_W;
    } else {
      drawX = SCREEN_WIDTH - STATUS_BT_ICON_W - STATUS_RIGHT_MARGIN;
    }
    drawBluetoothIcon(drawX, btY, btOn);
  }
}

void initBluetooth() {
  if (!BLUETOOTH_ENABLED) {
    return;
  }

  // Create Xbox gamepad device with XInput support for proper L3/R3 buttons
  // Use Xbox Series X controller configuration for proper VID/PID recognition
  xboxConfig = new XboxSeriesXControllerDeviceConfiguration();
  BLEHostConfiguration hostConfig = xboxConfig->getIdealHostConfiguration();

  xboxGamepad = new XboxGamepadDevice(xboxConfig);
  compositeHID.addDevice(xboxGamepad);
  compositeHID.begin(hostConfig);

  unsigned long startMs = millis();
  while (NimBLEDevice::getServer() == nullptr && (millis() - startMs) < 2000) {
    delay(10);
  }
  NimBLEServer* server = NimBLEDevice::getServer();
  if (server) {
    server->advertiseOnDisconnect(false);
  }

  // The library starts advertising without the device name in the payload.
  // Stop it, add the name, then restart via startBlePairing().
  NimBLEAdvertising* advertising = NimBLEDevice::getAdvertising();
  if (advertising) {
    advertising->stop();
    advertising->setName(BLE_DEVICE_NAME);
  }

  startBlePairing();
}

void startBleAdvertising() {
  if (!BLUETOOTH_ENABLED) {
    return;
  }
  NimBLEAdvertising* advertising = NimBLEDevice::getAdvertising();
  if (advertising) {
    advertising->start();
  }
}

void stopBleAdvertising() {
  if (!BLUETOOTH_ENABLED) {
    return;
  }
  NimBLEAdvertising* advertising = NimBLEDevice::getAdvertising();
  if (advertising) {
    advertising->stop();
  }
}

void startBlePairing() {
  if (!BLUETOOTH_ENABLED) {
    return;
  }
  blePairingActive = true;
  blePairingStartMs = millis();
  bleIconFlashOn = true;
  bleIconLastToggleMs = blePairingStartMs;
  startBleAdvertising();
}

void resetBlePressState() {
  if (!BLUETOOTH_ENABLED) {
    return;
  }
  if (xboxGamepad != nullptr && blePressHolding && bleActiveButton != 0) {
    xboxGamepad->release(bleActiveButton);
    xboxGamepad->sendGamepadReport();
  }
  if (blePressHolding && bleActiveButton != 0) {
    usbGamepadRelease(bleActiveButton);
    usbSendReport();
  }
  blePressHolding = false;
  bleActiveButton = 0;
  blePressDirection = 0;
  blePressStartMs = 0;
  bleLastPressMs = 0;
}

void clearBleSyncPhase() {
  bleSyncPhase = BLE_SYNC_NONE;
  bleSyncRemaining = 0;
  bleRefillRemaining = 0;
  bleSyncDirection = 0;
  bleRefillDirection = 0;
}

void resetBleSyncState() {
  if (!BLUETOOTH_ENABLED) {
    return;
  }
  clearBleSyncPhase();
  bleSyncTargetSteps = 0;
  bleSyncStepsMax = 0;
  bleEstimateValid = false;
}

int getBleMeterStepsForGame(int game) {
  game = clampGameIndex(game);
  if (game == 0) {
    if (!HID_BOKTAI1_MGBA_10_STEP_WORKAROUND) {
      return GAME_BARS[game];
    }
    return BOKTAI1_STEP_COUNT;
  }
  return GAME_BARS[game];
}

int getBleBarFromStep(int game, int step) {
  game = clampGameIndex(game);
  int stepsMax = getBleMeterStepsForGame(game);
  if (step < 0) {
    step = 0;
  }
  if (step > stepsMax) {
    step = stepsMax;
  }
  if (game == 0 && HID_BOKTAI1_MGBA_10_STEP_WORKAROUND) {
    return BOKTAI1_STEP_TO_BAR[step];
  }
  return step;
}

int getBleStepFromBar(int game, int bar, bool fromEmpty) {
  game = clampGameIndex(game);
  int barsMax = GAME_BARS[game];
  if (bar < 0) {
    bar = 0;
  }
  if (bar > barsMax) {
    bar = barsMax;
  }
  if (game == 0 && HID_BOKTAI1_MGBA_10_STEP_WORKAROUND) {
    return fromEmpty ? BOKTAI1_BAR_TO_STEP_FROM_EMPTY[bar] : BOKTAI1_BAR_TO_STEP_FROM_FULL[bar];
  }
  return bar;
}

int getBleActiveNumSteps() {
  if (bleSyncPhase != BLE_SYNC_NONE && bleSyncStepsMax > 0) {
    return bleSyncStepsMax;
  }
  return getBleMeterStepsForGame(currentGame);
}

// ---------------------------------------------------------------------------
// Single Analog mode (HID_CONTROL_MODE == 1)
// Maps the current bar count to a proportional deflection on one analog axis.
// The 0.0-1.0 range is divided into (numBars + 1) equal bands; we send the
// midpoint of the band for the current bar count.
// ---------------------------------------------------------------------------

void resetSingleAnalogState() {
  bleSingleAnalogBars = -1;
  bleSingleAnalogValue = 0;
  bleSingleAnalogActive = false;
  bleSingleAnalogButtonHeld = false;
  bleSingleAnalogLastRefreshMs = 0;
}

// Return the midpoint fraction for a given bar count.
// Boktai 1 (8 bars) → 9 bands, Boktai 2 & 3 (10 bars) → 11 bands.
float getSingleAnalogFraction(int bars, int numBars) {
  if (numBars <= 0) {
    return 0.0f;
  }
  int levels = numBars + 1;            // 0-bar band counts as a level
  float bandWidth = 1.0f / levels;
  float midpoint = (bars * bandWidth) + (bandWidth * 0.5f);
  if (midpoint > 1.0f) midpoint = 1.0f;
  return midpoint;
}

// Convert a 0.0–1.0 fraction to a signed stick deflection for the chosen axis.
// Positive axes map fraction to 0…XBOX_STICK_MAX,
// Negative axes map fraction to 0…XBOX_STICK_MIN (toward negative).
int16_t fractionToStickValue(float fraction, bool negative) {
  if (fraction <= 0.0f) return 0;
  if (fraction > 1.0f) fraction = 1.0f;
  if (negative) {
    return (int16_t)(fraction * XBOX_STICK_MIN);  // XBOX_STICK_MIN is negative
  }
  return (int16_t)(fraction * XBOX_STICK_MAX);
}

// Compute the stick outputs for Single Analog mode.
// Decomposes HID_SINGLE_ANALOG_AXIS into stick/axis/sign, maps frac via
// fractionToStickValue, and distributes the result to the correct output.
// Returns the computed scalar value so callers can test value != 0.
int16_t computeSingleAnalogSticks(float frac,
                                  int16_t& lx, int16_t& ly,
                                  int16_t& rx, int16_t& ry) {
  uint8_t axis = HID_SINGLE_ANALOG_AXIS;
  bool isLeft = (axis < 4);
  bool isX    = (axis % 4) < 2;
  bool isNeg  = (axis % 2) == 0;
  int16_t value = fractionToStickValue(frac, isNeg);
  lx = 0; ly = 0; rx = 0; ry = 0;
  if (isLeft) {
    if (isX) lx = value; else ly = value;
  } else {
    if (isX) rx = value; else ry = value;
  }
  return value;
}

void applySingleAnalog(int bars, int numBars) {
  if (!BLUETOOTH_ENABLED || xboxGamepad == nullptr) {
    return;
  }

  if (numBars < 0) numBars = 0;
  bars = constrain(bars, 0, numBars);

  bool barsChanged = (!bleSingleAnalogActive || bars != bleSingleAnalogBars);
  if (!barsChanged) {
    return;
  }

  float frac = getSingleAnalogFraction(bars, numBars);
  int16_t lx = 0, ly = 0, rx = 0, ry = 0;
  int16_t value = computeSingleAnalogSticks(frac, lx, ly, rx, ry);
  bool isLeft = (HID_SINGLE_ANALOG_AXIS < 4);

  // Release-and-repress the unlock button with every stick change so that
  // apps/emulators always register it, even if they started listening late.
  if (HID_METER_UNLOCK_BUTTON_ENABLED) {
    bool needButton = (value != 0);
    if (needButton) {
      if (bleSingleAnalogButtonHeld) {
        // Release first, send report, then re-press with the new stick value
        xboxGamepad->release(HID_METER_UNLOCK_BUTTON);
        xboxGamepad->sendGamepadReport();
      }
      xboxGamepad->press(HID_METER_UNLOCK_BUTTON);
      bleSingleAnalogButtonHeld = true;
      bleSingleAnalogLastRefreshMs = millis();
    } else if (bleSingleAnalogButtonHeld) {
      xboxGamepad->release(HID_METER_UNLOCK_BUTTON);
      bleSingleAnalogButtonHeld = false;
    }
  }

  // Only update the stick that this mode controls
  if (isLeft) {
    xboxGamepad->setLeftThumb(lx, ly);
  } else {
    xboxGamepad->setRightThumb(rx, ry);
  }
  xboxGamepad->sendGamepadReport();

  bleSingleAnalogBars = bars;
  bleSingleAnalogValue = value;
  bleSingleAnalogActive = true;
}

void releaseSingleAnalog() {
  if (!BLUETOOTH_ENABLED || xboxGamepad == nullptr) {
    resetSingleAnalogState();
    return;
  }

  bool changed = false;
  uint8_t axis = HID_SINGLE_ANALOG_AXIS;
  bool isLeft = (axis < 4);

  if (HID_METER_UNLOCK_BUTTON_ENABLED && bleSingleAnalogButtonHeld) {
    xboxGamepad->release(HID_METER_UNLOCK_BUTTON);
    changed = true;
  }

  if (bleSingleAnalogValue != 0) {
    if (isLeft) {
      xboxGamepad->setLeftThumb(0, 0);
    } else {
      xboxGamepad->setRightThumb(0, 0);
    }
    changed = true;
  }

  if (changed) {
    xboxGamepad->sendGamepadReport();
  }

  resetSingleAnalogState();
}

// Periodically release and re-press the unlock button so apps that start
// listening mid-session still register it as held.
void refreshSingleAnalogButton() {
  if (!BLUETOOTH_ENABLED || HID_CONTROL_MODE != 1) {
    return;
  }
  if (!HID_METER_UNLOCK_BUTTON_ENABLED || HID_METER_UNLOCK_REFRESH_MS == 0) {
    return;
  }
  if (!bleSingleAnalogButtonHeld || xboxGamepad == nullptr) {
    return;
  }

  unsigned long now = millis();
  if ((now - bleSingleAnalogLastRefreshMs) < HID_METER_UNLOCK_REFRESH_MS) {
    return;
  }

  xboxGamepad->release(HID_METER_UNLOCK_BUTTON);
  xboxGamepad->sendGamepadReport();
  xboxGamepad->press(HID_METER_UNLOCK_BUTTON);
  xboxGamepad->sendGamepadReport();
  bleSingleAnalogLastRefreshMs = now;
}

void applyBlePressEffect(int direction) {
  if (!bleEstimateValid) {
    return;
  }
  int stepsMax = getBleActiveNumSteps();
  if (stepsMax <= 0) {
    return;
  }
  if (direction > 0) {
    bleEstimatedSteps = min(bleEstimatedSteps + 1, stepsMax);
  } else if (direction < 0) {
    bleEstimatedSteps = max(bleEstimatedSteps - 1, 0);
  }
}

void finishBleSync() {
  if (!BLUETOOTH_ENABLED) {
    return;
  }
  clearBleSyncPhase();
  bleEstimatedSteps = bleSyncTargetSteps;
  bleEstimateValid = true;
}

void startBleResync(int deviceBars, int numBars) {
  if (!BLUETOOTH_ENABLED) {
    return;
  }
  if (!bleConnected || numBars <= 0) {
    return;
  }
  resetBlePressState();
  bleSyncPhase = BLE_SYNC_CLAMP;
  bleSyncStepsMax = getBleMeterStepsForGame(currentGame);
  int targetBars = constrain(deviceBars, 0, numBars);
  int middle = numBars / 2;
  int direction = (targetBars <= middle) ? BLE_DIR_DEC : BLE_DIR_INC;
  bleSyncTargetSteps = getBleStepFromBar(currentGame, targetBars, direction == BLE_DIR_DEC);
  bleSyncDirection = direction;
  bleSyncRemaining = bleSyncStepsMax;
  if (direction == BLE_DIR_DEC) {
    bleRefillDirection = BLE_DIR_INC;
    bleRefillRemaining = bleSyncTargetSteps;
  } else {
    bleRefillDirection = BLE_DIR_DEC;
    bleRefillRemaining = bleSyncStepsMax - bleSyncTargetSteps;
  }
  bleEstimateValid = false;
  bleLastResyncMs = millis();
}

void updateBluetoothState() {
  if (!BLUETOOTH_ENABLED) {
    return;
  }
  bool connectedNow = compositeHID.isConnected();
  if (connectedNow != bleConnected) {
    bleConnected = connectedNow;
    if (bleConnected) {
      blePairingActive = false;
      stopBleAdvertising();
      if (HID_CONTROL_MODE == 1) {
        bleSyncPending = false;
        resetBlePressState();
        resetBleSyncState();
        resetSingleAnalogState();
      } else {
        bleSyncPending = true;
        bleEstimateValid = false;
      }
    } else {
      resetBlePressState();
      resetBleSyncState();
      if (HID_CONTROL_MODE == 1) {
        releaseSingleAnalog();
      }
      // If a connection drops, re-enter pairing/advertising for the usual timeout.
      startBlePairing();
    }
  }

  if (blePairingActive && !bleConnected) {
    unsigned long now = millis();
    if (BLE_PAIRING_TIMEOUT_MS > 0 && (now - blePairingStartMs) >= BLE_PAIRING_TIMEOUT_MS) {
      blePairingActive = false;
      stopBleAdvertising();
    } else if ((now - bleIconLastToggleMs) >= BLE_ICON_FLASH_MS) {
      bleIconFlashOn = !bleIconFlashOn;
      bleIconLastToggleMs = now;
    }
  }
}

void updateUsbMeter(int bars, int numBars) {
  if (!usbHidActive) return;
  if (numBars <= 0) return;
  bars = constrain(bars, 0, numBars);
  bool usbIncrementalNeedsRefresh = (HID_CONTROL_MODE == 0) &&
                                    (!BLUETOOTH_ENABLED || !bleConnected) &&
                                    hidGameChanged;
  if (bars == usbMeterBars && numBars == usbMeterNumBars && !usbIncrementalNeedsRefresh) return;
  usbMeterBars = bars;
  usbMeterNumBars = numBars;

  if (HID_CONTROL_MODE == 1) {
    float frac = getSingleAnalogFraction(bars, numBars);
    int16_t lx = 0, ly = 0, rx = 0, ry = 0;
    int16_t value = computeSingleAnalogSticks(frac, lx, ly, rx, ry);
    bool isLeft = (HID_SINGLE_ANALOG_AXIS < 4);

    if (HID_METER_UNLOCK_BUTTON_ENABLED) {
      if (value != 0) {
        usbGamepadPress(HID_METER_UNLOCK_BUTTON);
      } else {
        usbGamepadRelease(HID_METER_UNLOCK_BUTTON);
      }
    }

    if (isLeft) {
      usbGamepadSetLeftStick(lx, ly);
    } else {
      usbGamepadSetRightStick(rx, ry);
    }
    usbSendReport();
  } else {
    // In Incremental mode, USB must keep working even when BLE is disabled
    // or currently disconnected.
    if (!BLUETOOTH_ENABLED || !bleConnected) {
      if (hidGameChanged || bleDeviceNumBars != numBars) {
        bleEstimateValid = false;
        hidGameChanged = false;
      }
      bleDeviceBars = bars;
      bleDeviceNumBars = numBars;
      if (!bleEstimateValid) {
        bleEstimatedSteps = getBleStepFromBar(currentGame, bleDeviceBars, true);
        bleEstimateValid = true;
      }
    }
  }
}

void updateBluetoothMeter(int deviceBars, int numBars) {
  if (!BLUETOOTH_ENABLED) {
    return;
  }
  if (!bleConnected) {
    return;
  }

  bleDeviceBars = constrain(deviceBars, 0, numBars);
  bleDeviceNumBars = numBars;

  if (HID_CONTROL_MODE == 1) {
    if (hidGameChanged) {
      resetSingleAnalogState();
      hidGameChanged = false;
    }
    applySingleAnalog(bleDeviceBars, bleDeviceNumBars);
    return;
  }

  if (bleSyncPending || hidGameChanged) {
    startBleResync(bleDeviceBars, bleDeviceNumBars);
    bleSyncPending = false;
    hidGameChanged = false;
    return;
  }

  if (BLE_RESYNC_ENABLED && BLE_RESYNC_INTERVAL_MS > 0 && bleSyncPhase == BLE_SYNC_NONE) {
    unsigned long now = millis();
    if ((now - bleLastResyncMs) >= BLE_RESYNC_INTERVAL_MS) {
      startBleResync(bleDeviceBars, bleDeviceNumBars);
    }
  }
}

void handleBlePresses() {
  if (HID_CONTROL_MODE == 1) {
    return;
  }
  bool blePathActive = BLUETOOTH_ENABLED && bleConnected;
  bool usbPathActive = usbHidActive;
  if (!blePathActive && !usbPathActive) {
    return;
  }

  unsigned long now = millis();

  if (blePressHolding) {
    if ((now - blePressStartMs) >= blePressHoldMs) {
      if (xboxGamepad != nullptr) {
        xboxGamepad->release(bleActiveButton);
        xboxGamepad->sendGamepadReport();
      }
      usbGamepadRelease(bleActiveButton);
      usbSendReport();
      blePressHolding = false;
      applyBlePressEffect(blePressDirection);
      if (bleSyncPhase != BLE_SYNC_NONE) {
        bleSyncRemaining--;
        if (bleSyncRemaining <= 0) {
          if (bleSyncPhase == BLE_SYNC_CLAMP) {
            if (bleSyncDirection == BLE_DIR_DEC) {
              bleEstimatedSteps = 0;
            } else {
              bleEstimatedSteps = bleSyncStepsMax;
            }
            bleEstimateValid = true;
            bleSyncPhase = BLE_SYNC_REFILL;
            bleSyncRemaining = bleRefillRemaining;
            bleSyncDirection = bleRefillDirection;
            if (bleSyncRemaining <= 0) {
              finishBleSync();
            }
          } else {
            finishBleSync();
          }
        }
      }
    }
    return;
  }

  if (blePressIntervalMs == 0) {
    return;
  }
  if ((now - bleLastPressMs) < blePressIntervalMs) {
    return;
  }

  int direction = 0;
  if (bleSyncPhase != BLE_SYNC_NONE) {
    if (bleSyncRemaining > 0) {
      direction = bleSyncDirection;
    }
  } else if (bleEstimateValid) {
    int estimatedBars = getBleBarFromStep(currentGame, bleEstimatedSteps);
    if (bleDeviceBars > estimatedBars) {
      direction = BLE_DIR_INC;
    } else if (bleDeviceBars < estimatedBars) {
      direction = BLE_DIR_DEC;
    }
  }

  if (direction == 0) {
    return;
  }

  blePressDirection = direction;
  bleActiveButton = (direction > 0) ? HID_BUTTON_INC : HID_BUTTON_DEC;
  blePressHolding = true;
  blePressStartMs = now;
  bleLastPressMs = now;
  if (xboxGamepad != nullptr) {
    xboxGamepad->press(bleActiveButton);
    xboxGamepad->sendGamepadReport();
  }
  usbGamepadPress(bleActiveButton);
  usbSendReport();
}

void initHidPressTiming() {
  if (HID_BUTTONS_PER_SECOND == 0) {
    blePressIntervalMs = 0;
    blePressHoldMs = 0;
  } else {
    blePressIntervalMs = 1000UL / HID_BUTTONS_PER_SECOND;
    if (blePressIntervalMs == 0) {
      blePressIntervalMs = 1;
    }
    blePressHoldMs = blePressIntervalMs / 2;
    if (blePressHoldMs == 0) {
      blePressHoldMs = 1;
    }
  }
}

// Calculate battery % based on analog reading
void updateBatteryStatus() {
  if (!BATTERY_SENSE_ENABLED) {
    return;
  }

  unsigned long now = millis();
  if ((now - lastBatterySampleTime) < BATTERY_SAMPLE_MS) {
    return;
  }
  lastBatterySampleTime = now;

  cachedBatteryPct = readBatteryPercentage();

  if (BLUETOOTH_ENABLED && cachedBatteryPct >= 0) {
    compositeHID.setBatteryLevel((uint8_t)cachedBatteryPct);
  }
}

void handleLowBatteryCutoff() {
  if (!BATTERY_SENSE_ENABLED || !BATTERY_CUTOFF_ENABLED) {
    return;
  }
  if (cachedBatteryVoltage <= 0.0f) {
    return;
  }

  unsigned long now = millis();
  if (cachedBatteryVoltage <= VOLT_CUTOFF) {
    if (lowBatteryStart == 0) {
      lowBatteryStart = now;
    }
    if ((now - lowBatteryStart) >= BATTERY_CUTOFF_HOLD_MS) {
      display.clearDisplay();
      display.setTextSize(1);
      display.setCursor(31, 28);
      display.print("LOW BATTERY");
      display.display();
      delay(1500);
      enterDeepSleep();
    }
  } else {
    lowBatteryStart = 0;
  }
}

int readBatteryPercentage() {
  // Read multiple samples and average for stability
  uint32_t sum = 0;
  for (int i = 0; i < 10; i++) {
    sum += analogRead(BAT_PIN);
  }
  float raw = sum / 10.0f;
  cachedBatteryAdcAvg = raw;
  hasBatteryReading = true;
  
  // ESP32-S3 ADC: 12-bit (0-4095), default ~0-3.3V range
  // VOLT_DIVIDER_MULT compensates for voltage divider ratio + ADC variance
  // Calibrate in config.h if battery % is wrong at full charge
  float voltage = (raw / 4095.0f) * 3.3f * VOLT_DIVIDER_MULT;
  cachedBatteryVoltage = voltage;
  
  if (serialEnabled && DEBUG_SERIAL_BATTERY) {
    Serial.print("Battery ADC raw: "); Serial.print(raw);
    Serial.print(" Voltage: "); Serial.println(voltage);
  }

  float range = VOLT_MAX - VOLT_MIN;
  if (range <= 0.0f) {
    return 0;  // Guard: VOLT_MAX must be greater than VOLT_MIN
  }
  int pct = ((voltage - VOLT_MIN) / range) * 100;
  return constrain(pct, 0, 100);
}

#if defined(SENSOR_LTR390)
bool initLTR390() {
  const int maxAttempts = 3;

  for (int attempt = 0; attempt < maxAttempts; attempt++) {
    if (ltr.begin()) {
      return true;
    }

    if (serialEnabled) {
      Serial.print("LTR390 init failed (");
      Serial.print(attempt + 1);
      Serial.println(")");
    }

    delay(50);
  }

  return false;
}

// Calculate UV Index from raw sensor data
float calculateUVI() {
  uint32_t rawUVS = ltr.readUVS();
  float divisor = (uvDivisor > 0.0f) ? uvDivisor : UV_SENSITIVITY_COUNTS_PER_UVI;
  float measuredUvi = (float)rawUVS / divisor;
  float correctedUvi = applyEnclosureCompensation(measuredUvi);

  cachedRawUVS = rawUVS;
  cachedUviRaw = measuredUvi;
  
  // Debug output
  if (serialEnabled && DEBUG_SERIAL_UV) {
    Serial.print("UV raw: "); Serial.print(rawUVS);
    Serial.print(" UVI measured: "); Serial.print(measuredUvi, 3);
    Serial.print(" UVI corrected: "); Serial.println(correctedUvi, 3);
  }

  return correctedUvi;
}
#endif
