TideGear/BoktaiSensor/GBA Link Patches/Source/b1e.asm

.gba
.open "Clean\Boktai 1 (E).gba","Boktai 1 (E)(Hack).gba",0x08000000

.org 0x080000D4 // sunlight changer
.area 0xCC

// set link port to GPIO mode if not yet set
ldr	r0,=4000134h
ldrh	r1,[r0]
mov	r2,r1
ldr	r3,=0FFF0h	// all bits except data
and	r2,r3
ldr	r3,=8000h	// GPIO mode, all inputs
cmp	r2,r3
beq	@@readio
strh	r3,[r0]
b	@@end		// skip GPIO read this cycle

@@readio:
lsl	r1,r1,1Ch
lsr	r0,r1,1Ch	// keep data bits only

cmp	r0,0Fh		// no link activity: all lines pulled high
beq	@@nolink

mov	r2,r0
lsl	r2,r2,1Fh
lsr	r2,r2,1Fh	// frame phase from SC

mov	r3,06h
and	r3,r0		// keep SD/SI bits (bit1 + bit2; SO arrives on SI via cable crossover)
mov	r0,r3
lsr	r0,r0,2h	// SI -> bit0
mov	r1,2h
and	r3,r1		// SD -> bit1
orr	r3,r0		// 2-bit payload pair

ldr	r1,=0203FFF0h
cmp	r2,0h
beq	@@phase0

strb	r3,[r1,1h]	// high pair
ldrb	r0,[r1]
lsl	r3,r3,2h
orr	r0,r3
b	@@linkwrite

@@phase0:
strb	r3,[r1]		// low pair
ldrb	r0,[r1,1h]
lsl	r0,r0,2h
orr	r0,r3
b	@@linkwrite

@@nolink:
mov	r0,0Fh
b	@@sunwrite

@@linkwrite:
ldrb	r2,[r1,2h]	// load last confirmed index
strb	r0,[r1,2h]	// store current index
cmp	r0,r2		// same as last frame?
bne	@@end		// different: skip (glitch or pending change)

@@sunwrite:
add	r3,=dataarea
ldrb	r3,[r3,r0]
ldr	r1,=3004528h
str	r3,[r1]

@@end:
pop	r15

.pool

dataarea:
// GBA GPIO pins are pulled up, so no connection reads as 0xF; treat as no sunlight
dcb	0x00,0x04,0x0B,0x14,0x1F,0x2F,0x4D,0x77,0x8C,0x8C,0x8C,0x8C,0x8C,0x8C,0x8C,0x00

.endarea

.org 0x081BB59C	// hook
bl	80000D4h

.org 0x080120E4 // treat negative as empty gauge
bgt	80120EAh
.org 0x0801212C // treat negative as empty gauge
bgt	8012132h

.org 0x0801219E // skip sunlight value adjustment
b	80121BEh

.org 0x08011FB8	// set default sensor calibration value
mov	r0,0E6h
nop

.org 0x081C0300	// stop sensor from saving sunlight value
nop

.org 0x081C017C	// skip solar sensor reset
nop
.org 0x081C039C // skip solar sensor reset
nop
.org 0x081C03D0 // skip solar sensor reset
nop

.org 0x080447F6	// kill "Solar Sensor is broken" screen
b	8044874h

.close
