TideGear/BoktaiSensor/(commit log)

2026-01-06 Add power button with deep sleep support (3s hold on/off)
    Implement power button functionality using ESP32-S3 deep sleep mode for
    battery-powered operation.
    Hardware:
    - Tactile push button on GP2 with internal pull-up (active LOW)
    - Simple 2-wire connection: GP2 to button, button to GND
    Behavior:
    - Hold 3 seconds to power ON from deep sleep
    - Hold 3 seconds to power OFF (enters deep sleep)
    - Deep sleep draws ~10µA vs ~40mA active
    Implementation:
    - config.h: Added BUTTON_PIN, DEBOUNCE_MS, LONG_PRESS_MS constants
    - BoktaiSensor.ino: Added handlePowerButton() for sleep detection,
    waitForLongPress() for startup confirmation, enterDeepSleep() using
    esp_sleep_enable_ext0_wakeup() for butto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
2026-01-08 Add multi-game support with auto-calibration mode
    Implement Boktai-specific UV-to-bar mapping for all three games with
    automatic and manual calibration modes.
    Game Support:
    - Boktai 1: The Sun Is in Your Hand (8-bar gauge)
    - Boktai 2: Solar Boy Django (10-bar gauge)
    - Boktai 3: Sabata's Counterattack (10-bar gauge)
    - Tap button to cycle between games
    - Display shows game name and appropriate gauge size
    Automatic Mode (default):
    - Uses AUTO_UV_MIN and AUTO_UV_MAX to define the UV range
    - Automatically calculates bar thresholds for each game
    - Evenly distributes bars across the UV range
    - Simple 2-value calibration for all games
    Manual Mode (advanced):
    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
2026-01-10 Optimize LTR390 sensor for direct sunlight measurement
    Configure LTR390 UV sensor settings for optimal direct sunlight readings.
    Changes:
    - Gain: 3x → 1x (prevents saturation when pointing at direct sun)
    - Resolution: 18-bit → 13-bit (fastest measurement rate at 12.5ms)
    Rationale:
    - 1x gain provides maximum headroom for intense UV without clipping
    - 13-bit resolution is sufficient for 8-10 bar gauge accuracy
    - Faster readings improve responsiveness
    - Power consumption unchanged (sensor is <1% of total draw)
    The Adafruit library automatically compensates for gain when calculating
    UV Index, so the output values remain correctly calibrated.
    Also documented sensor settings and UV-blockin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
    [BoktaiSensor.ino]
2026-01-10 Fix UV Index calculation for Adafruit LTR390 library v1.1.2
    The Adafruit LTR390 library v1.1.2 does not include a readUVI() method,
    only readUVS() which returns raw sensor counts. This commit implements
    manual UV Index calculation from raw data.
    - Added UV calculation constants (sensitivity=2300, gain=1.0, int_factor=0.125)
    - Added calculateUVI() function using formula:
    UVI = raw_uvs / (SENSITIVITY × GAIN_FACTOR × INT_TIME_FACTOR)
    - For our settings (1x gain, 13-bit): UVI = raw / 287.5
    - Updated README to reflect manual UV Index calculation
    This ensures compatibility with the current library version while
    maintaining accurate UV Index output for Boktai bar mapping.
    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
    [BoktaiSensor.ino]
2026-01-11 Fix UV sensor, wake behavior, battery monitoring, and add charging detection
    UV SENSOR FIX:
    - Changed resolution from 13-bit (12.5ms) to 18-bit (100ms)
    - Updated UV_DIVISOR from 4.0 to 32.0 to match new settings
    - 13-bit only gave ~4 counts/UVI causing constant 0 readings
    - 18-bit gives ~32 counts/UVI for reliable measurements
    WAKE BEHAVIOR IMPROVEMENTS:
    - Cold boot: Shows "Hold 3s to power on" immediately (fixes garbage screen)
    - Wake from sleep: Display stays off until button pressed
    - Both modes: 10-second inactivity timeout returns to deep sleep
    - Button activity resets the timeout timer
    - Device powers on immediately when 3-second hold is reached
    BATTERY MONITORING:
    - Changed ADC pin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
    [BoktaiSensor.ino, config.h]
2026-01-11 Add battery voltage divider calibration constant
    Add configurable VOLT_DIVIDER_MULT to compensate for ADC and resistor variance
    in battery monitoring circuit.
    - Add VOLT_DIVIDER_MULT constant to config.h (default 2.25)
    - Update getBatteryPercentage() to use configurable multiplier
    - Document battery calibration in README (BATTERY MONITORING and TROUBLESHOOTING)
    The theoretical 2:1 voltage divider ratio (2.0 multiplier) often shows incorrect
    battery percentage due to ADC calibration differences and resistor tolerances.
    The new default of 2.25 compensates for typical hardware variance.
    Users can adjust VOLT_DIVIDER_MULT if battery % is still wrong at full charge:
    - Increase value i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
    [BoktaiSensor.ino, config.h]
2026-01-12 Simplify to USB power, rename to Ojo del Sol
    Remove battery functionality in favor of USB power from phone/emulator
    - Remove battery monitoring code (voltage divider, ADC reading, charging detection)
    - Remove battery icon and percentage display from UI
    - Remove battery-related config (BAT_PIN, VOLT_MIN, VOLT_MAX, VOLT_DIVIDER_MULT)
    - Update hardware requirements: USB power replaces LiPo battery and resistors
    - Add future plan: optional power from GBA link port
    - Rename project from "BOKTAI SOLAR SENSOR" to "Ojo del Sol"
    The device now draws power directly from USB, which is more practical when
    used alongside a phone or emulation device that already has USB available.
    [BoktaiSensor.ino, config.h]
2026-01-14 Revert "Simplify to USB power, rename to Ojo del Sol"
    This reverts commit d6004faac2645aab0f93177c7f43434f664a6f0b.
    [BoktaiSensor.ino, config.h]
2026-01-14 Switch to XIAO ESP32S3 for built in charger
2026-01-15 Add optional LTR390 GPIO power control
2026-01-15 Remove UV clamp, default GPIO UV sensor power,
2026-01-15 Refine XIAO power/battery handling and align docs
    - Power LTR390 after user confirmation, retry init with power cycling, and gate debug logs.
    - Make battery/USB sensing optional with an unknown indicator; show raw UVI without clamping.
    - Update README wiring/board setup and replace the battery divider diagram with ASCII.
    [BoktaiSensor.ino, config.h]
2026-01-15 Remove charge detection UI and hide battery indicator when disabled
    - Drop VBUS sensing config/logic and CHG animation paths.
    - Hide the battery icon when battery sensing is off.
    - Clarify LTR390 LED behavior when powered by GPIO in README.
2026-01-15 Add low-voltage cutoff and improve wake/UI behavior
    - Track battery voltage and enter deep sleep after sustained low readings, with configurable threshold/hold time.
    - Allow single press-and-hold to power on from sleep, tighten loop timing, and guard auto UV ranges.
    - Adjust UV readout position and update README troubleshooting and battery/wake documentation.
    [BoktaiSensor.ino, config.h]
2026-01-17 Reduce OLED sleep draw by disabling charge pump and tri-stating I2C
    - Send SSD1306 display off + charge pump off before deep sleep.
    - End I2C and set SDA/SCL to inputs to reduce back-powering.
    - Document OLED low-power sleep behavior and remaining LED glow caveat.
2026-01-17 Add configurable screensaver with bouncing logo
    add SCREENSAVER_ACTIVE and SCREENSAVER_TIME config plus inactivity timer
    render a bouncing “Ojo del Sol” while UV/GBA output continues; wake press doesn’t change game
    document screensaver behavior and OLED lifespan note in README.md
    [BoktaiSensor.ino, config.h]
2026-01-18 Enhance screensaver visuals and wake-up splash
    add Ojo del Sol bitmap and centered battery readout to the screensaver block
    increase screensaver spacing and update collision bounds for the larger layout
    show a centered logo + text wake-up splash and extend it to ~2 seconds
    [BoktaiSensor.ino]
2026-01-18 Stabilize UV bars and auto-scale UVI divisor
    add EMA smoothing and hysteresis controls for steadier bar updates
    compute UV divisor from current gain/resolution with a safe fallback
    document filtering knobs and dynamic UVI scaling in README.md
    [BoktaiSensor.ino, config.h]
2026-01-19 Switch LTR390 to datasheet UVI settings and update docs
    configure UVS for gain 18, 20-bit, and 500ms rate; derive divisor fallback from 2300 counts/UVI
    add direct MEAS_RATE register write and update UVI debug expectations
    refresh README UVI settings and note the Palmr gb-link-cable PCB for the link port
2026-01-21 Add BLE HID meter sync and status UI
    Add BLE HID gamepad support with pairing/timeout, clamp+refill resync, and configurable button mapping/press rate.
    Implement Boktai 1’s 10-step input mapping for correct 8-bar behavior.
    Add Bluetooth status icon on main and screensaver displays and document BLE behavior/config.
    [BoktaiSensor.ino, config.h]
2026-01-22 Switch to ESP32-BLE-CompositeHID with Xbox controller support for L3/R3
    Replace ESP32-BLE-Gamepad library with ESP32-BLE-CompositeHID to fix
    Bluetooth gamepad button mapping issues on Android and PC.
    - Use XboxGamepadDevice with Xbox Series X controller configuration
    for proper XInput compatibility on both platforms
    - Change solar meter control from L2/R2 (buttons 9/10) to L3/R3
    (Xbox Left Stick/Right Stick clicks) using XBOX_BUTTON_LS (0x2000)
    and XBOX_BUTTON_RS (0x4000)
    - Add sendGamepadReport() calls after button press/release as required
    by the new library
    - Update bleActiveButton type from uint8_t to uint16_t to accommodate
    Xbox button bitmask values
    The device now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
    [BoktaiSensor.ino, config.h]
2026-01-22 Add BLE chord control mode for bar inputs
    add a chord-hold BLE mode that maps each bar count to L3 + stick directions
    expose a control mode switch to choose incremental vs chord behavior
    document numeric control-mode values and chord mapping in README
2026-01-22 Mention rsync skip for chord mode, fix inverted stick Y
    [BoktaiSensor.ino, config.h]
2026-01-22 Add toggle for Boktai 1 mGBA 10‑step workaround
    Add BLE_BOKTAI1_MGBA_10_STEP_WORKAROUND in config.h to enable/disable the 10‑step mapping.
    Gate Boktai 1 BLE step count and bar/step conversions on that flag.
    Document the toggle in the BLE section of README.md and tighten the Incremental mode sentence.
    [BoktaiSensor.ino, config.h]
2026-01-24 Add prototype photos link to README
    Added a link to photos of a prototype.
2026-01-24 Fix chord-mode L3 reliability
    Chord Control Mode now re-asserts L3 (LS click) on each bar change (release → press) and sends explicit reports, preventing intermittent “dropped” L3 holds on some hosts/emulators.
    README clarifies that BLE_BUTTONS_PER_SECOND applies to Incremental mode only; Chord mode is immediate and re-asserts L3 for reliability.
    [BoktaiSensor.ino]
2026-01-24 Clarify prototype size in README
    Added a note about the expected size of the assembled prototype.
2026-01-24 Clarify device calibration help in README
    Updated README to clarify device calibration help
2026-01-25 Trying more accurate voltage divider setting
2026-01-25 Tuned voltage divider multiplier
2026-01-25 Fix deep sleep oversights
    [BoktaiSensor.ino]
2026-01-28 Reorganize config and make UV filtering opt-in
    Config organization: Restructure config.h into clearer sections (calibration, power, UI, connectivity, debug).
    UV smoothing defaults: Set UVI_SMOOTHING_ENABLED = false and UVI_SMOOTHING_ALPHA = 0.5, with notes that UVI_SMOOTHING_ALPHA = 1.0 behaves like smoothing disabled.
    Bar hysteresis toggle: Add BAR_HYSTERESIS_ENABLED (default false) and gate hysteresis logic on it (equivalent to BAR_HYSTERESIS = 0.0 when disabled).
    Docs: Update README.md stability tuning section to document the new flag and defaults.
    [BoktaiSensor.ino, config.h]
2026-01-28 Add DEBUG tuning screen and refine UV stability settings
    Add OLED DEBUG screen (optional via DEBUG_SCREEN_ENABLED) to show raw UV counts + scaled UVI, plus battery ADC average + computed voltage + computed percent for calibration.
    Change button behavior to cycle screens (game screens + DEBUG when enabled) without changing the underlying game selection logic.
    Make UV “stability” controls clearer/safer by default: smoothing defaults off with UVI_SMOOTHING_ALPHA = 0.5, add BAR_HYSTERESIS_ENABLED to explicitly gate hysteresis, and document equivalences (alpha = 1.0 ≈ smoothing off; hysteresis disabled ≈ BAR_HYSTERESIS = 0.0).
    Improve config/docs clarity: reorganize config.h sections and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
    [BoktaiSensor.ino, config.h]
2026-01-30 Switch chord mode to dual‑stick chords (no L3)
    Replace chord mapping with left/right stick direction pairs for bars 0–10 and remove L3 press/release logic in chord mode.
    Update docs/config comments to reflect the new chord mapping and no‑L3 behavior.
    [BoktaiSensor.ino, config.h]
2026-01-30 Change photo link for unfinished prototype
    Updated the link to photos of the unfinished prototype.
2026-02-12 Add Single Analog BLE control mode, remove Chord mode
    Replace Chord mode with a new Single Analog mode (BLE_CONTROL_MODE = 1) that
    encodes the solar sensor bar count as proportional deflection on a single
    configurable analog stick axis (default: Right Stick X+).
    The 0.0-1.0 axis range is divided into equal bands (9 for Boktai 1's 8-bar
    gauge, 11 for Boktai 2/3's 10-bar gauge) and the midpoint of each band is
    sent as the stick value.
    A configurable "meter unlock" button (default: R3) is held while the axis is
    deflected, allowing emulators to gate meter changes behind a button hold so
    normal stick input doesn't affect the solar sensor. The button is released and
    re-pressed on every deflectio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
    [BoktaiSensor.ino, config.h]
2026-02-12 Add UV enclosure transmission compensation to UVI conversion
    Add configurable UV enclosure compensation for boxed sensors by introducing UV_ENCLOSURE_COMP_ENABLED, UV_ENCLOSURE_TRANSMITTANCE, and UV_ENCLOSURE_UVI_OFFSET in config.h. Apply compensation once immediately after raw-to-UVI conversion in calculateUVI(), clamp corrected values at zero, and keep DEBUG UVI as measured (pre-compensation). Expand serial debug output to show measured vs corrected UVI. Update README with enclosure-compensation setup, calibration workflow, formula notes, troubleshooting guidance, and a note that DEBUG-screen UVI is pre-compensation.
    [BoktaiSensor.ino, config.h]
2026-02-12 Revert "Add UV enclosure transmission compensation to UVI conversion"
    This reverts commit 7d301245434c251ac0f318f0a59ac3d439b4ee0e.
    [BoktaiSensor.ino, config.h]
2026-02-12 Reapply "Add UV enclosure transmission compensation to UVI conversion"
    This reverts commit 8f38d77d6b3c1c3b247cd409aee9ba8781850a1e.
    [BoktaiSensor.ino, config.h]
2026-02-12 Fix deep-sleep wake prompt and OLED re-enable reliability
    Improve wake behavior after deep sleep so the UI is consistently visible.
    - Add SSD1306 wake helpers that explicitly re-enable charge pump + display before drawing.
    - Use a shared prompt renderer for the "Hold 3s to power on" screen.
    - Simplify wake gating: always show the power-on prompt immediately, including after a short wake tap.
    - While holding the button, periodically refresh the prompt so missed first draws recover.
    - Keep explicit OLED charge-pump disable on sleep using named constants for symmetric sleep/wake control.
    - Update README wake/power/troubleshooting sections to match the new behavior.
    [BoktaiSensor.ino]
2026-02-12 fix: stabilize startup battery state and align auto/single-analog behavior docs
    - Initialize battery cache as unknown on boot so the UI does not briefly show a false 0% before the first ADC sample.
    - Rename AUTO_UV_MAX to AUTO_UV_SATURATION and align firmware/comments/docs with saturation-ceiling semantics.
    - Refactor manual bar-threshold selection to reuse getManualThresholds(game) in one place.
    - Remove the redundant isBluetoothReserved() indirection and use BLUETOOTH_ENABLED directly.
    - Clarify Single Analog midpoint mapping in docs: 0 bars still sends a small non-zero deflection.
    [BoktaiSensor.ino, config.h]
2026-02-12 Fix bugs, remove redundancies, and improve code quality across firmware and docs
    Bugs fixed:
    - Display init failure no longer hangs forever; enters deep sleep instead
    - Division-by-zero guard added for VOLT_MAX == VOLT_MIN misconfiguration
    - xboxConfig heap pointer stored globally to prevent orphaned allocation
    - I2C pins (SDA/SCL) and SSD1306 I2C address extracted to named constants
    in config.h, replacing hardcoded magic numbers in two separate locations
    Redundancies removed:
    - Collapsed duplicate battery state init (identical if/else branches)
    - Screensaver battery icon drawing now reuses drawBatteryGauge()
    - UV_DIVISOR_FALLBACK derived from UV_SENSITIVITY_COUNTS_PER_UVI
    - Extracted cle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
    [BoktaiSensor.ino, config.h]
2026-02-12 Fix battery safety defaults, decouple battery checks, and tighten screensaver/axis docs
    - Set safer defaults in config:
    - BATTERY_SENSE_ENABLED = false
    - BATTERY_CUTOFF_ENABLED = false
    - Clarify AUTO_UV_* naming in auto-threshold comments
    - Decouple battery sampling/cutoff from UV new-data events by running
    updateBatteryStatus() and handleLowBatteryCutoff() in the main loop.
    - Refine screensaver status-row logic:
    - Show BLE icon row only when BLE is actively pairing/connected
    (or battery data is present)
    - Recompute screensaver layout when BLE status visibility changes.
    - Improve gauge rendering robustness:
    - Guard against invalid totalBars
    - Center segmented gauge based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
    [BoktaiSensor.ino, config.h]
2026-02-13 Fix emulator pseudocode bug, clean up redundancies and vestigial code
    Fix incorrect Single Analog Mode decoding formula in emulator dev docs.
    The pseudocode normalized the full signed axis range (-1..+1 → 0..1)
    when the firmware only outputs in the positive half, causing every bar
    count to decode wrong (e.g. 0 bars decoded as 4 on Boktai 1).
    Also:
    - Fix enterDeepSleep not releasing a remapped BLE_METER_UNLOCK_BUTTON
    - Remove dead initial values for blePressIntervalMs/blePressHoldMs
    - Remove UV_DIVISOR_FALLBACK alias; use UV_SENSITIVITY_COUNTS_PER_UVI directly
    - Early-return in updateBatteryStatus when battery sensing is disabled
    - Rename LTR390_MEAS_RATE_500MS to MEAS_RATE_500MS to avoid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
    [BoktaiSensor.ino, config.h]
2026-02-13 Fix OLED-init sleep path consistency and BLE press-state reset
    Use the normal deep-sleep path when SSD1306 initialization fails, and harden BLE state cleanup.
    - Route OLED init failure through `enterDeepSleep()` instead of direct `esp_deep_sleep_start()`.
    - Add `displayInitialized` so deep-sleep display shutdown commands run only when the display was actually initialized.
    - Guard NimBLE advertising/deinit calls in `enterDeepSleep()` so early-boot failure paths don't touch uninitialized BLE state.
    - Fix `resetBlePressState()` to always clear internal press-tracking fields even if `xboxGamepad` is null; only send release/report when a gamepad object exists.
    - Docs: update troubleshooting note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
    [BoktaiSensor.ino]
2026-02-14 Add compensated UVI to debug screen and standardize UVI to 3 decimal places
    Add a "UVI comp'ed" line to the debug screen showing the post-enclosure-
    compensation UV Index alongside the existing raw/measured values. Remove
    the battery percentage line to make room.
    Standardize all UVI values to 3 decimal places across display output,
    serial logging, config.h constants, and documentation to match the
    LTR-390 sensor's actual resolution (~0.0004 UVI per count).
2026-02-17 Fixed incorrect GPIO for GBA link pin
    [config.h]
2026-02-20 Switch to new framed 3-wire protocol for GBA link, tweak volt divider mult
    [Cheap GBA Link Continuity for Ojo del Sol.csv]
2026-02-20 Link patch source fix, add ips patch files
    [b1e.asm, b1j.asm, b1u.asm, b1ub.asm, b2e.asm, b2j.asm, b2j1.asm, b2u.asm]
2026-02-21 Fix GBA link patches: EWRAM state storage and SO/SI cable crossover
    Fixed two bugs in all 9 GBA link ASM patches that caused the in-game
    sun meter to flicker and display incorrect values when using a GBA link
    cable with the Ojo del Sol.
    1. Moved linkstate pair storage from ROM (0x08xxxxxx) to EWRAM
    (0x0203FFF0). On flash carts where ROM writes are silently ignored,
    the stored pairs always read back as zero, causing the reconstructed
    lookup index to alternate between two wrong values every frame.
    2. Changed the bit extraction mask from 0x0A (bits 1+3) to 0x06
    (bits 1+2) and the shift from >>3 to >>2. Standard GBA link cables
    cross SO and SI (pin 2 <-> pin 3), so the ESP32's S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
    [b1e.asm, b1j.asm, b1u.asm, b1ub.asm, b2e.asm, b2j.asm, b2j1.asm, b2u.asm]
2026-02-22 Harden GBA link against pin-sampling race condition
    Reorder ESP32 GPIO writes so data pins (SD, SO) are set before the
    phase pin (SC), ensuring the GBA always samples stable data when it
    detects a phase edge.
    Add a consecutive-match check to all 9 GBA ASM patches: the
    reconstructed 4-bit index is stored at 0x0203FFF2 each frame and
    only applied to the sun register when two consecutive frames agree.
    This silently discards any single-frame misread caused by sampling
    during a pin transition, at the cost of one frame (~17ms) of latency
    on legitimate bar changes.
    README updated with a note about both measures.
2026-02-24 Update prototype photo link and GBA Link Cable status
    Updated the link to the prototype photos and clarified the status of the GBA Link Cable.
2026-02-24 Update README with case information and link
    Added case dimensions and link to product.
2026-02-24 Add case dimensions to prototype photo section
    Updated README to include case dimensions for prototype.
2026-03-01 feat: add Xbox 360 XInput USB mode with debug-screen CDC toggle
    Add XboxHIDGamepad.h with Xbox 360-style TinyUSB descriptors/report format and BLE-to-XInput button mapping.
    Implement runtime USB mode switching via RTC flag:
    Normal boot: XInput (Ojo del Sol)
    Debug-screen long press (2s): reboot to CDC upload mode (Ojo del Sol (CDC))
    CDC-mode long press (2s): clear flag, sleep, next wake returns to XInput.
    Fix ESP32 core 3.3.6 TinyUSB transfer call by passing the required is_isr argument to usbd_edpt_xfer(...).
    Update BoktaiSensor.ino to use XInput report flow with 16-bit stick values and shadow USB state.
    Fix meter/update behavior to send one final USB report per change (resolves dropped upda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
    [BoktaiSensor.ino, XboxHIDGamepad.h]
2026-03-01 Stabilize CDC upload-mode OLED rendering and document TinyUSB CDC upload requirements
    - Reworked CDC mode UI to a compact two-line message:
    "Firmware Upload Mode" / "Hold 2s to Return"
    with screensaver-style bouncing movement.
    - Hardened CDC mode entry/runtime flow:
    - require button release after entering CDC mode (prevents accidental immediate long-press action)
    - release I2C before software restart into CDC mode
    - skip SSD1306 internal Wire.begin and keep explicit SDA/SCL pin config
    - force wake + redraw on CDC entry for more reliable first frame
    - Fixed intermittent CDC display state drift by reasserting canonical SSD1306 panel mode on wake:
    - normal polarity (A6)
    - defa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
    [BoktaiSensor.ino, config.h]
2026-03-03 Fix HID mode parity across USB/BLE and align transport docs
    - Fix HID incremental control over USB so it no longer depends on BLE being enabled/connected.
    - Keep USB and BLE incremental logic aligned by using shared step/bar mapping helpers.
    - Add shared HID press timing initialization and reuse it in setup/BLE init paths.
    - Fix CDC-mode setup compile safety by ensuring CDC draw/setup calls stay inside HAS_USB_HID guards.
    - Update docs to use current HID_* setting names (replacing stale BLE_* references in emulator-dev docs).
    - Clarify in README that both control modes (Incremental + Single Analog) work over both Bluetooth and USB XInput.
    - Separate Bluetooth-only behavior in README (pairing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
    [BoktaiSensor.ino, config.h]
2026-03-03 Fix USB HID gating, improve GBA link phase timing, and clean up BLE lifecycle
    - Honor USB_HID_ENABLED at runtime by skipping USB XInput startup when disabled.
    - Make GBA framed-link phase timing use micros()-based scheduling (with catch-up),
    so GBA_LINK_FRAME_TOGGLE_MS is applied accurately instead of being limited by loop delay.
    - Reduce main loop idle delay from 10ms to 1ms to keep control paths responsive.
    - Free BLE gamepad/config objects before deep sleep to avoid heap leaks across runtime cycles.
    - Remove redundant initHidPressTiming() call during Bluetooth init.
    Docs:
    - Clarify USB_HID_ENABLED=false behavior in USB XInput section.
    - Update GBA_LINK_FRAME_TOGGLE_MS timing notes to r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
    [BoktaiSensor.ino]
2026-03-03 Fix CDC OLED state drift after restart (mirror/invert/wrap artifacts)
    - Hardened CDC display recovery by forcing SSD1306 back to a known-good state in wakeDisplayHardware().
    - Added explicit controller commands on CDC draw/wake:
    - deactivate scroll (0x2E)
    - display-all-on resume (0xA4)
    - normal display polarity (0xA6)
    - default segment remap/com scan (0xA1, 0xC8)
    - reset display offset/start line (0xD3 -> 0x00, 0x40)
    - This fixes intermittent CDC-mode rendering glitches where text appeared mirrored, inverted, or vertically wrapped/off-screen after switching to CDC mode.
    [BoktaiSensor.ino]
2026-03-03 Tweaked default volt divider multiplier
2026-03-05 Various bugfixes
    BoktaiSensor.ino
    Fix 1: Removed if (BLUETOOTH_ENABLED) guard — bleGameChanged = true now fires unconditionally on every game switch, fixing USB-only incremental mode stale estimate when switching between same-bar-count games.
    Fix 2: Added computeSingleAnalogSticks() helper (~20 lines before applySingleAnalog). Both applySingleAnalog and updateUsbMeter now call it instead of duplicating the isLeft/isX/isNeg/value/zero-init pattern.
    config.h
    Fix 5: DEBUG_SERIAL changed from true → false. Serial logging is now opt-in.
    README.md
    Fix 3 (Screensaver): Added "SCREENSAVER_ACTIVE = false" as a documented alternative to SCREENSAVER_TIME = 0.
    Fix 5 (DEBUG_SERIAL): Troubleshootin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
    [BoktaiSensor.ino, config.h]
2026-03-05 feat: Full-operation CDC mode with Serial debugging, XInput/CDC label, USB_HID_ENABLED auto-CDC
    CDC mode now runs the complete normal firmware (UV sensing, game display,
    screensaver, BLE, GBA link, battery) instead of showing a static bouncing
    "Firmware Upload Mode" screen. This allows DEBUG_SERIAL output to be viewed
    during live sensor operation.
    - CDC mode runs full loop; removed cdcModeLoop(), drawCdcModeScreen(),
    initCdcModeLayout(), and ~15 associated state variables
    - DEBUG screen header now shows "XInput" or "CDC" in place of "DEBUG"
    - Added serialEnabled flag: Serial writes are suppressed in XInput mode
    (no CDC endpoint is exposed, making them wasteful). Serial.begin()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
2026-03-07 feat: enable UV enclosure compensation with 0.833 transmittance default
    Enable UV_ENCLOSURE_COMP_ENABLED by default and set UV_ENCLOSURE_TRANSMITTANCE
    to 0.833, derived from a very quick and dirty open/closed measurement (UVI 10.2 open, 8.5 closed)
    taken at ~11:45 AM in California on a clear day.
    This compensates for UV attenuation through the enclosure window so that
    calibration values remain meaningful regardless of housing material.
    Users with different enclosures should re-measure and adjust the value.
2026-03-09 Harden game index handling and sync README enclosure default
2026-03-11 Add open-air-equivalent threshold mode for enclosure compensation
2026-03-12 Revert "Merge pull request #3 from TideGear/codex/perform-comprehensive-codebase-review-ht7uzd"
    This reverts commit dde85ec14a448069b53489f9a63a92fbaac61c40, reversing
    changes made to ecc51e3b948f03edc611e1ccc67959c6534b71d5.
    [BoktaiSensor.ino, config.h]
2026-03-12 Revert "Add open-air-equivalent threshold mode for enclosure compensation"
    This reverts commit bb2a4f205a2127eeea7d703a22002dfc8d7db0f1.
    [BoktaiSensor.ino]
2026-03-12 Increase CDC boot double-flush delay to reduce blank screen on restart
    Increase the inter-flush delay in the CDC boot double-flush from 10ms to
    50ms. This gives the SSD1306 panel more time to process and settle after
    the first framebuffer write before the second flush reinforces it, reducing
    the frequency of the intermittent blank screen seen on CDC mode restart.
    The SSD1306 charge pump does not lose power during a software restart, but
    its internal state is scrambled. The double-flush (added in b3ac6c8) handles
    the common case; the longer gap pushes more of the tail cases into reliable
    recovery without affecting normal wake-from-sleep boot time.
    [BoktaiSensor.ino]
2026-03-12 Add UV_THRESHOLDS_CALIBRATED_OPEN_AIR calibration mode setting
    Adds UV_THRESHOLDS_CALIBRATED_OPEN_AIR (bool, default true) to config.h.
    When true (default), threshold values in config.h (AUTO_UV_MIN,
    AUTO_UV_SATURATION, and manual calibration arrays) are treated as
    open-air UVI values measured with the case open. The firmware compares
    compensated (open-air equivalent) UVI against thresholds, which is the
    correct behavior for the default calibration workflow and is unchanged
    from prior behavior.
    When false, bar comparison uses the raw (pre-compensation) sensor
    reading directly, for users who calibrated their thresholds with the
    sensor inside the closed enclosure.
    For always-open-air builds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
    [BoktaiSensor.ino, config.h]
2026-03-12 New wiring recommendations and volt div mult tweak
2026-03-12 Fix game switching, always-on diagnostics screen, and XInput cleanup
    - make the XInput/CDC diagnostics screen always present and remove the
    DEBUG_SCREEN_ENABLED toggle from the firmware/config flow
    - refresh cached bar state immediately when switching Boktai versions so
    display/HID/GBA output does not lag until the next UV sample
    - add defensive game-index clamping across UV threshold and BLE step/bar
    helper paths to avoid out-of-bounds access on invalid indices
    - stop BLE single-analog disconnect cleanup from clearing active USB HID
    state
    - fix TinyUSB XInput endpoint handling so endpoint claims are only
    released on transfer failure
    - remove stale SENSOR_POWER_PIN config comments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
    [BoktaiSensor.ino, XboxHIDGamepad.h, config.h]
2026-03-17 Fix code quality issues and update operational config defaults
    Code quality fixes (from full codebase review):
    - Fix: debug screen "UVI comp'ed" now shows cachedUvi (the value
    actually used for bar calculation) instead of cachedUviCorrected
    (which was pre-smoothing). Matters when UVI_SMOOTHING_ENABLED = true.
    README note updated to match.
    - Fix: screensaver text cursor now applies getTextBounds() x1/y1 offsets,
    consistent with how the wake splash screen positions its text. Added
    screensaverTextX1/Y1 globals; stored and applied in drawScreensaver().
    - Remove dead code: unreachable SCREENSAVER_ENABLED guard in
    drawScreensaver() — the function is only called when screensaverAct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
    [BoktaiSensor.ino, XboxHIDGamepad.h, config.h]
2026-03-19 Fix BLE device name missing from advertising payload
    NimBLE-Arduino's BleCompositeHID sets the GAP device name via
    NimBLEDevice::setDeviceName(), which makes it available as a GATT
    characteristic but does not add it to the advertising PDU. As a result,
    scanners and OS device pickers only saw the name intermittently (e.g.
    from cache or after a full GATT connection).
    In initBluetooth(), after the library's internal taskServer completes
    and starts advertising, we now stop advertising, call
    setName(BLE_DEVICE_NAME) on the NimBLEAdvertising object, and restart
    via startBlePairing(). This injects the name into the advertising packet
    so it appears consistently to any scanner doing passive or activ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
    [BoktaiSensor.ino]
2026-03-21 Replace linear bar mapping with Raphi's cartridge-accurate non-linear thresholds
    The previous AUTO mode distributed bars linearly across the UV range. This replaces
    it with the original Boktai cartridge's actual non-linear bar thresholds, reverse-
    engineered by Raphi (raphi.xyz/~raphi/boktai/sensor_graph/). Boktai 1 and Boktai
    2/3 each have their own threshold curve; both are stored as fixed ratio tables in
    the firmware and scaled to any configured [UV_MIN, UV_SATURATION] range.
    The manual calibration section in config.h is also simplified: the three per-bar
    float arrays (BOKTAI_1_UV[8], BOKTAI_2_UV[10], BOKTAI_3_UV[10]) are replaced with
    per-game BOKTAI_1/2/3_UV_MIN and BOKTAI_1/2/3_UV_SAT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
    [Cheap GBA Link Continuity.csv]
2026-03-21 Adjust runtime defaults and add serial device-button logging
    - log each physical device-button press to Serial when DEBUG_SERIAL is enabled
    - cover both the wake/power-on path and the normal runtime button handler
    - sync runtime button state after startup so a held wake press is not logged again as a new runtime press
    - enable battery sensing by default
    - enable low-voltage cutoff
    - switch HID control mode to Single Analog
    - disable periodic battery Serial spam while leaving UV debug output enabled
    - document DEBUG_SERIAL behavior in config comments and README, including the new button-press log line
2026-03-25 Early real-cartridge test calibration
    Based on UV flashlight and a real cartridge of Boktai 3.
2026-03-25 Remove dead code and fix README calibration values
    Code cleanup with no functional changes:
    - Remove unused `cachedUviCorrected` variable: was assigned in
    `calculateUVI()` but never read. `cachedUviRaw` and `cachedUvi`
    already cover all consumers (pre- and post-compensation UVI).
    - Remove dead `screensaverX/Y` center-init in `setup()`:
    `updateScreensaverState()` unconditionally resets them to center on
    every activation, so the setup-time values were never reached.
    - Simplify NimBLE deinit guard in `enterDeepSleep()`: drop redundant
    `|| blePairingActive || bleConnected` — both states require
    `xboxGamepad != nullptr` (assigned before pairing starts in
    `initBluetooth()`), so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
    [BoktaiSensor.ino]
2026-03-25 Fix UVI display label
    BoktaiSensor.ino:
    - Main display UV label now shows "cUVI:" when UV_ENCLOSURE_COMP_ENABLED
    is true, or "UVI:" when false, instead of the ambiguous "UV:"
    [BoktaiSensor.ino]
2026-03-26 Additional real-cartridge test calibration
    Based on UV flashlight and a real cartridge of Boktai 1.
2026-03-26 First real-sun-light test/calibration
    The previous UV flashlight tests were way off.
    Real-sunlight calibration (2026-03-26, California, clear noon). Test method: open sensor (no enclosure cover) held near original Boktai 3 cartridge. In-game 0-1 bar and 7-8 bars compared to Ojo del Sol uncomp'ed UVI. 10 bars was not achieved with the available sunlight, so it was calculated based on Raphi's sensor graph.
2026-03-28 Update README.md
    Add some sensor info and update credits
2026-04-01 Update README with detailed tuning instructions
    Clarified the goal of tuning device settings for sunlight handling.
2026-04-01 More fine tuning of UV min and saturation
    Note: When there is ambiguity in my measurements caused by things such as...
    1. How UVI is affected by overcast vs. partly cloudy vs. clear sky
    2. Flickering meter bars with an actual Boktai cartridge
    3. Rapidly changing (uncomp'ed) UVI readings on the Ojo del Sol
    4. Differences between how the LTR390 detects UV and how a Boktai cartridge sensor does
    5. Etc.
    ...I opt for what requires more sunlight or at least splits the difference. Accuracy when compared to the original game cartridges is most important to me, but when decisions have to be made, I opt for challenge. The Ojo del Sol is meant to be the no-cheating solution. However, keep in mind, we a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
2026-04-01 Update prototype photo links in README
2026-07-20 Experimental T-QT Pro support
    Unrelated: also added sensor ref doc
2026-07-28 T-QT Pro: switch display to Arduino_GFX, fix bootloop, refine buttons
    - Replace TFT_eSPI with Arduino_GFX (GC9107): TFT_eSPI 2.5.43 crashes in
    tft.init() on ESP32-S3 with esp32 core 3.x (StoreProhibited -> boot loop).
    No library config file editing needed anymore.
    - Default LTR390 I2C back to the Qwiic connector (SDA=43, SCL=44);
    IO33/IO34 solder pads documented as the alternative.
    - Swap tap directions: right button (GPIO47) advances to the next screen,
    left button (GPIO0, power) tap goes backward; configurable via
    BUTTON_TAP_STEP/BUTTON2_TAP_STEP.
    - Add boot serial diagnostics: wait up to 5s for the CDC host, print a
    board banner and per-stage init markers so crashes are locata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
2026-07-29 Fix T-QT Pro crash on sleep; persist screen across wake
    Holding the power button never slept the device: enterDeepSleep() reset the
    chip partway through BLE teardown, before reaching esp_deep_sleep_start().
    The long-press logic itself was fine.
    NimBLEDevice::deinit(true) released the NimBLE stack's memory, then
    delete xboxGamepad ran XboxGamepadDevice's destructor over the
    NimBLECharacteristic pointers that had just been freed, while the
    compositeHID global still held the device pointer from addDevice(). The
    resulting fault was invisible on USB CDC because panic output goes to the
    UART / USB-Serial-JTAG instead.
    Deep sleep powers the radio down and resets the chip on wake, so there is
    no h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
2026-07-29 Restore default config values
    Personal build settings leaked into the T-QT Pro commits. Restore the
    repository defaults so a fresh clone gets safe, documented behavior:
    - USB_HID_ENABLED back to true
    - DEBUG_SERIAL back to false, DEBUG_SERIAL_BATTERY back to true
    - HID_CONTROL_MODE back to 0 (Incremental), which three earlier commits
    deliberately kept as the default
    - BATTERY_SENSE_ENABLED (XIAO branch) back to false and
    BATTERY_CUTOFF_ENABLED back to false; both had been flipped on against
    their own comments, which say to keep them off until the divider is
    wired and verified
    The T-QT Pro stays the selected board. Its UNTESTED warning is now stale,
    so it is replaced with a note tha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
2026-07-30 Pull up the deep-sleep wake pin so ext0 cannot fire immediately
    The device woke the instant it slept and came back to the power-on prompt.
    pinMode(BUTTON_PIN, INPUT_PULLUP) does not survive deep sleep: the pad is
    switched to RTC control and the digital pull-up is dropped. With no external
    pull-up the pin floats, and ext0's level-0 trigger fires right away.
    Enable the RTC pull-up (and disable the pull-down) on the wake pin at every
    sleep entry, in both enterDeepSleep() and exitCdcModeAndSleep(). Nothing in
    the firmware configured rtc_gpio at all previously.
    Also replace the flat 50ms post-release delay with a requirement that the pin
    read HIGH continuously for 250ms before ext0 is armed, so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
2026-10-20 Add untested calibrator device
2026-10-21 Improve calibrator
2026-10-22 Make T-QT Pro the default, add cartridge sensor option, calibrator Wi-Fi
    T-QT Pro:
    - Mark the T-QT Pro build as tested and make it the default board
    (README options swapped: T-QT is Option A)
    - Disable the screensaver on the T-QT Pro (LCD, no burn-in; backlight
    stays on so it saved no power)
    Cartridge sensor (UNTESTED, T-QT Pro only, off by default):
    - SENSOR_GBA_CARTRIDGE reads a real Boktai cartridge's solar sensor in
    place of the LTR390 and maps it to bars with the games' level formula
    and bar tables (CART_CALIBRATION dark baseline, Boktai 1 (E) table)
    - Ticks run from a hardware timer interrupt on core 1, away from the
    Bluetooth stack; readings with a late tick are discarded
    -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
2026-10-22 README: fix stale XIAO/OLED-only wording now that the T-QT Pro is the default
    - Quick Start names the T-QT power button; display-only mode says screen
    - Note the cartridge sensor in the wiring note, libraries and board settings
    - Describe the T-QT's sleep handling alongside the OLED's
    - Move the screensaver status-row sentence back to the general paragraph
2026-10-22 README: drop the core version recommendation and the unsourced sleep current
    Say esp32 core 3.x instead of recommending 3.3.7, and mark deep sleep
    current as not measured rather than quoting ~10 uA.
